X-Microsystems/xmicro-6502/README.md

# XMICRO-6502

W65C02 CPU card for the [XMICRO Bus](https://github.com/X-Microsystems/xmicro-bus).

Datasheet: [XMICRO-6502](Documentation/XMICRO-6502.pdf)

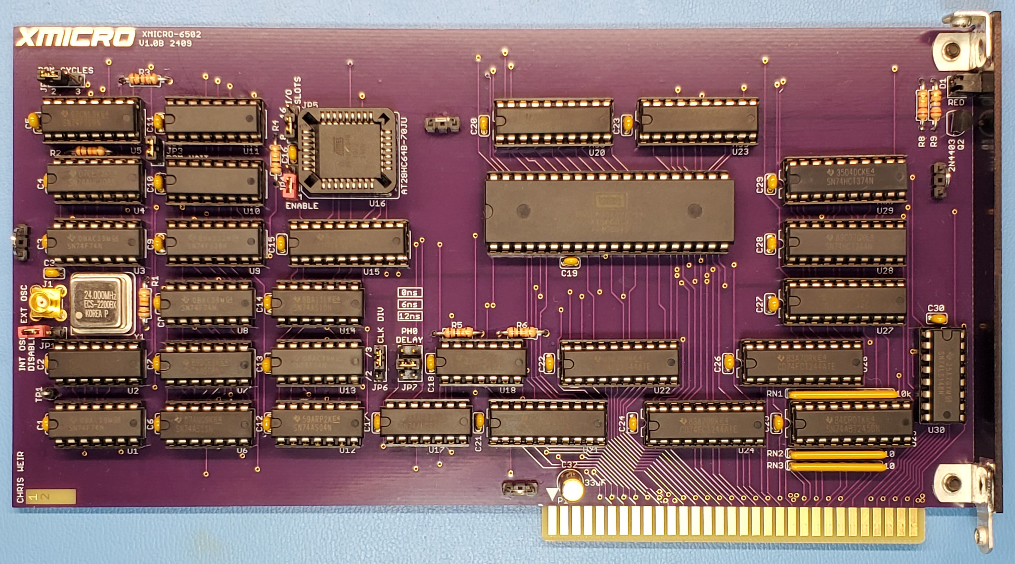
[picture p1: Images/XMICRO-6502 1.jpg]
XMICRO-6502
