X-Microsystems/xmicro-6502/Documentation/Schematics/XMICRO-6502 V2.3 Netlist.txt

Netlist

Exported from XMICRO-6502 V2.3.sch at 12/8/2019 8:15:32 PM

EAGLE Version 6.3.0 Copyright (c) 1988-2012 CadSoft

Net      Part     Pad      Pin        Sheet

!BBUSACK PC0      20       !BUSACK    6
         U8       7        Y2         1

!BCBR    PC0      12       !CBR       6
         U4       11       I          4

!BCSX    PC0      9        !CSX       6
         U1       4        G2A        5
         U2       5        G2B        5

!BFETCH  PC0      19       !FETCH     6
         U8       14       Y3         1

!BHALT   PC0      17       !HALT      6
         U8       5        Y3         1

!BINH    PC0      11       !INH       6
         U17      11       O          3

!BINT    PC0      51       !INT       6
         U18      10       I1         1

!BIOSEL  PC0      16       !IOSEL     6
         U25      18       Y1         1

!BIRQ0   PC0      53       !IRQ0      6
         U27      2        I1         3

!BIRQ1   PC0      54       !IRQ1      6
         U27      5        I1         3

!BIRQ2   PC0      55       !IRQ2      6
         U27      13       I1         3

!BIRQ3   PC0      56       !IRQ3      6
         U27      10       I1         3

!BIRQ4   PC0      57       !IRQ4      6
         U28      5        I1         3

!BIRQ5   PC0      58       !IRQ5      6
         U28      2        I1         3

!BIRQ6   PC0      59       !IRQ6      6
         U28      13       I1         3

!BIRQ7   PC0      60       !IRQ7      6
         U28      10       I1         3

!BIRQX   PC0      52       !IRQX      6
         U10      8        !Q         4

!BNMI    JP5      1        1          1
         PC0      61       !NMI       6

!BRD     PC0      21       !RD        6
         U1       5        G2B        5
         U2       2        B          5
         U8       18       Y1         1

!BRST    PC0      14       !RST       6
         U31      1        I          1

!BUSACK  U10      10       PRE        4
         U8       13       A2         1
         U9       10       PRE        4
         U9       6        !Q         4

!BWAIT   PC0      18       !WAIT      6
         U31      13       I          1

!BWR     PC0      22       !WR        6
         U2       3        C          5
         U8       16       Y2         1

!CINT    U18      8        O          1
         U20      4        !IRQB      1

!CS0_READ U12      1        G          2
         U12      19       G          2
         U2       11       Y4         5

!CS0_WRITE U10      3        CLK        2
         U11      11       CLK        2
         U2       13       Y2         5

!CS1_READ U2       10       Y5         5
         U21      1        G          3
         U21      19       G          3

!CS1_WRITE U2       12       Y3         5
         U26      11       CLK        3

!HALT    R2       1        1          6
         U17      8        O          1
         U8       15       A3         1

!IOSEL   U25      2        A1         1
         U6       19       P=Q        5

!IVP     U16      1        OC         3
         U18      4        I0         4
         U22      9        Y6         3

!MLB     U18      2        I1         4
         U20      5        !MLB       1

!RD      U17      3        O          1
         U22      5        G2B        3
         U8       2        A1         1

!RST     U10      4        PRE        2
         U11      1        CLR        2
         U18      5        I1         4
         U20      40       !RESB      1
         U26      1        CLR        3
         U31      4        O          1
         U9       1        CLR        4
         U9       13       CLR        4

!VINT    U18      9        I0         1
         U23      14       GS         3

!VPB     JP3      2        2          2
         U19      5        I          3
         U20      1        !VPB       1
         U22      4        G2A        3

!WAIT_DMA R7       2        2          1
         U17      9        I0         1
         U9       8        !Q         4

!WR      U17      6        O          1
         U8       4        A2         1

A0       U20      9        A0         1
         U22      1        A          3
         U24      17       A4         1

A1       U18      12       I0         3
         U20      10       A1         1
         U22      2        B          3
         U24      2        A1         1

A2       U18      13       I1         3
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
         U23      5        EI         3
         U23      8        GND        * none *
         U24      10       GND        * none *
         U25      10       GND        * none *
         U26      10       GND        * none *
         U27      7        GND        * none *
         U28      7        GND        * none *
         U29      8        GND        * none *
         U3       7        GND        * none *
         U30      7        GND        * none *
         U31      7        GND        * none *
         U4       7        GND        * none *
         U5       10       3B         2
         U5       13       4B         2
         U5       3        1B         2
         U5       6        2B         2
         U5       8        GND        * none *
         U6       10       GND        * none *
         U6       18       Q7         5
         U7       10       GND        * none *
         U7       12       Q4         2
         U7       14       Q5         2
         U7       16       Q6         2
         U7       18       Q7         2
         U7       5        Q1         2
         U7       7        Q2         2
         U7       9        Q3         2
         U8       10       GND        * none *
         U8       11       A1         1
         U8       19       G          1
         U8       8        A4         1
         U9       12       D          4
         U9       7        GND        * none *
         Y1       4        GND        1

ID0      U13      2        A1         5

ID1      U13      17       A4         5

ID2      U13      4        A2         5

ID3      U13      15       A3         5

ID4      U13      6        A3         5

ID5      U13      13       A2         5

ID6      U13      8        A4         5

ID7      U13      11       A1         5

N$1      JP2      2        2          1
         U30      12       D          1

N$2      U17      5        I1         1
         U19      4        O          1

N$3      JP1      1        1          1
         JP2      3        3          1
         U3       1        I0         1
         U30      5        Q          1

N$4      U15      1        DIR        1
         U17      1        I0         1
         U19      3        I          1
         U20      34       R!WB       1

N$5      U3       5        I1         1
         U30      9        Q          1

N$6      U16      4        3D         3
         U23      9        A0         3

N$7      U16      5        4D         3
         U23      7        A1         3

N$8      U3       6        O          1
         U4       5        I          1

N$9      R5       1        1          1
         Y1       1        OE         1

N$10     JP4      2        2          5
         R4       1        1          5
         U6       1        G          5

N$11     U17      10       I1         1
         U19      12       O          1

N$12     U18      3        O          4
         U9       2        D          4

N$13     U19      11       I          3
         U23      15       EO         3

N$14     U17      13       I1         3
         U19      6        O          3

N$15     U14      1        G          3
         U14      19       G          3
         U22      7        Y7         3

N$16     U10      13       CLR        4
         U18      6        O          4

N$17     U18      1        I0         4
         U4       10       O          4

N$18     U16      6        5D         3
         U23      6        A2         3

N$19     U11      19       Q8         2
         U12      2        A1         2
         U5       2        1A         2

N$20     Q1       2        B          6
         R2       2        2          6

N$21     U3       2        I1         1
         U4       6        O          1

N$22     U17      12       I0         3
         U18      11       O          3

N$23     U4       12       O          4
         U4       3        I          4

N$24     Q1       3        C          6
         R1       2        2          6

N$25     U4       4        O          4
         U9       3        CLK        4

N$26     D1       A        A          6
         R1       1        1          6

N$27     U11      5        Q2         2
         U12      4        A2         2
         U5       11       3A         2

N$28     U15      11       B8         1
         U20      26       D7         1

N$29     U15      12       B7         1
         U20      27       D6         1

N$30     U15      13       B6         1
         U20      28       D5         1

N$31     U15      14       B5         1
         U20      29       D4         1

N$32     U15      15       B4         1
         U20      30       D3         1

N$33     U15      16       B3         1
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
         U21      20       VCC        * none *
         U22      16       VCC        * none *
         U22      6        G1         3
         U23      16       VCC        * none *
         U24      20       VCC        * none *
         U25      20       VCC        * none *
         U26      20       VCC        * none *
         U27      14       VCC        * none *
         U28      14       VCC        * none *
         U29      10       3B         2
         U29      11       3A         2
         U29      13       4B         2
         U29      14       4A         2
         U29      16       VCC        * none *
         U29      5        2A         2
         U29      6        2B         2
         U3       14       VCC        * none *
         U30      1        CLR        1
         U30      10       PRE        1
         U30      13       CLR        1
         U30      14       VCC        * none *
         U30      4        PRE        1
         U31      14       VCC        * none *
         U31      5        I          6
         U31      9        I          6
         U4       14       VCC        * none *
         U5       16       VCC        * none *
         U6       12       Q4         5
         U6       14       Q5         5
         U6       16       Q6         5
         U6       2        P0         5
         U6       20       VCC        * none *
         U6       3        Q0         5
         U6       4        P1         5
         U6       5        Q1         5
         U6       6        P2         5
         U6       7        Q2         5
         U6       8        P3         5
         U6       9        Q3         5
         U7       2        P0         2
         U7       20       VCC        * none *
         U7       3        Q0         2
         U8       20       VCC        * none *
         U9       14       VCC        * none *
         U9       4        PRE        4
         Y1       8        VCC        1
