X-Microsystems/xmicro-6502/Images/XMICRO-6502 2.jpg

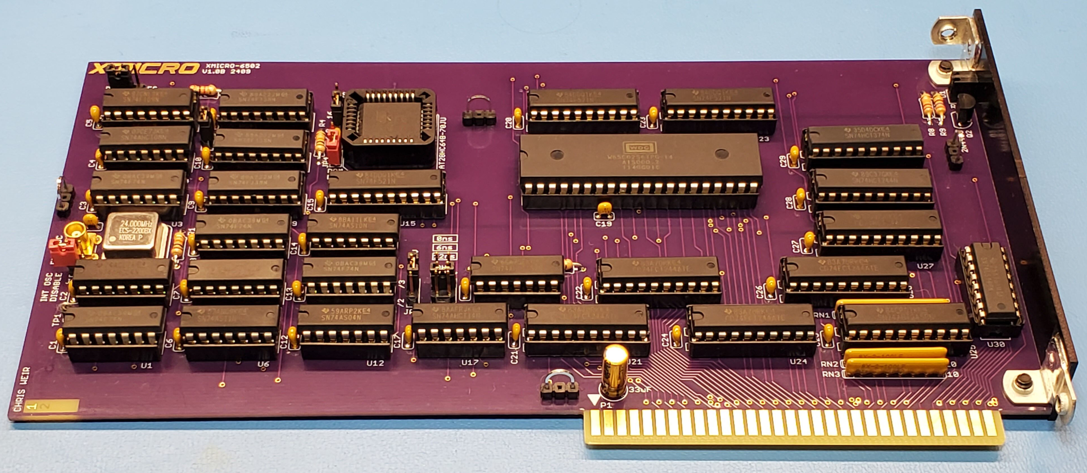
Images/XMICRO-6502 2.jpg
