X-Microsystems/xmicro-6502/Images/XMICRO-6502 Gen 1.jpg

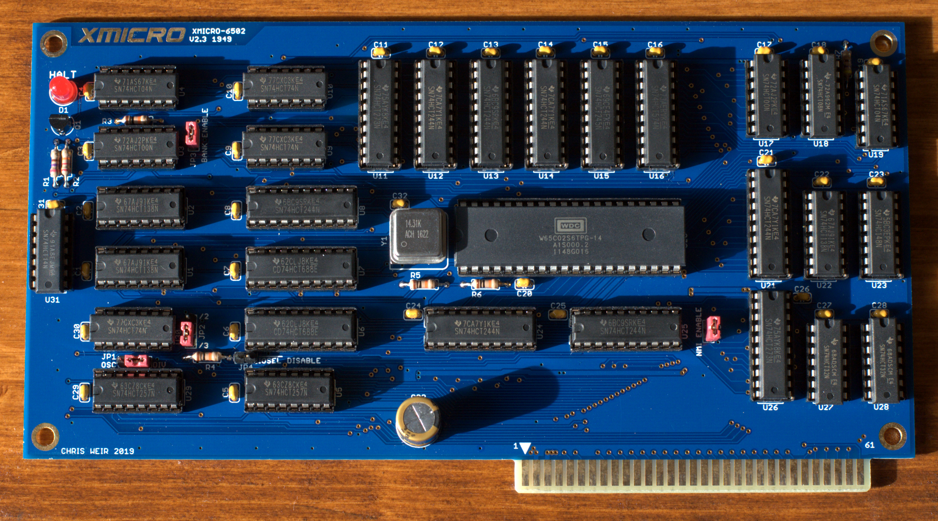
Images/XMICRO-6502 Gen 1.jpg
