X-Microsystems/xmicro-6502/Documentation/Schematics/XMICRO-6502 V1.0B Black.pdf

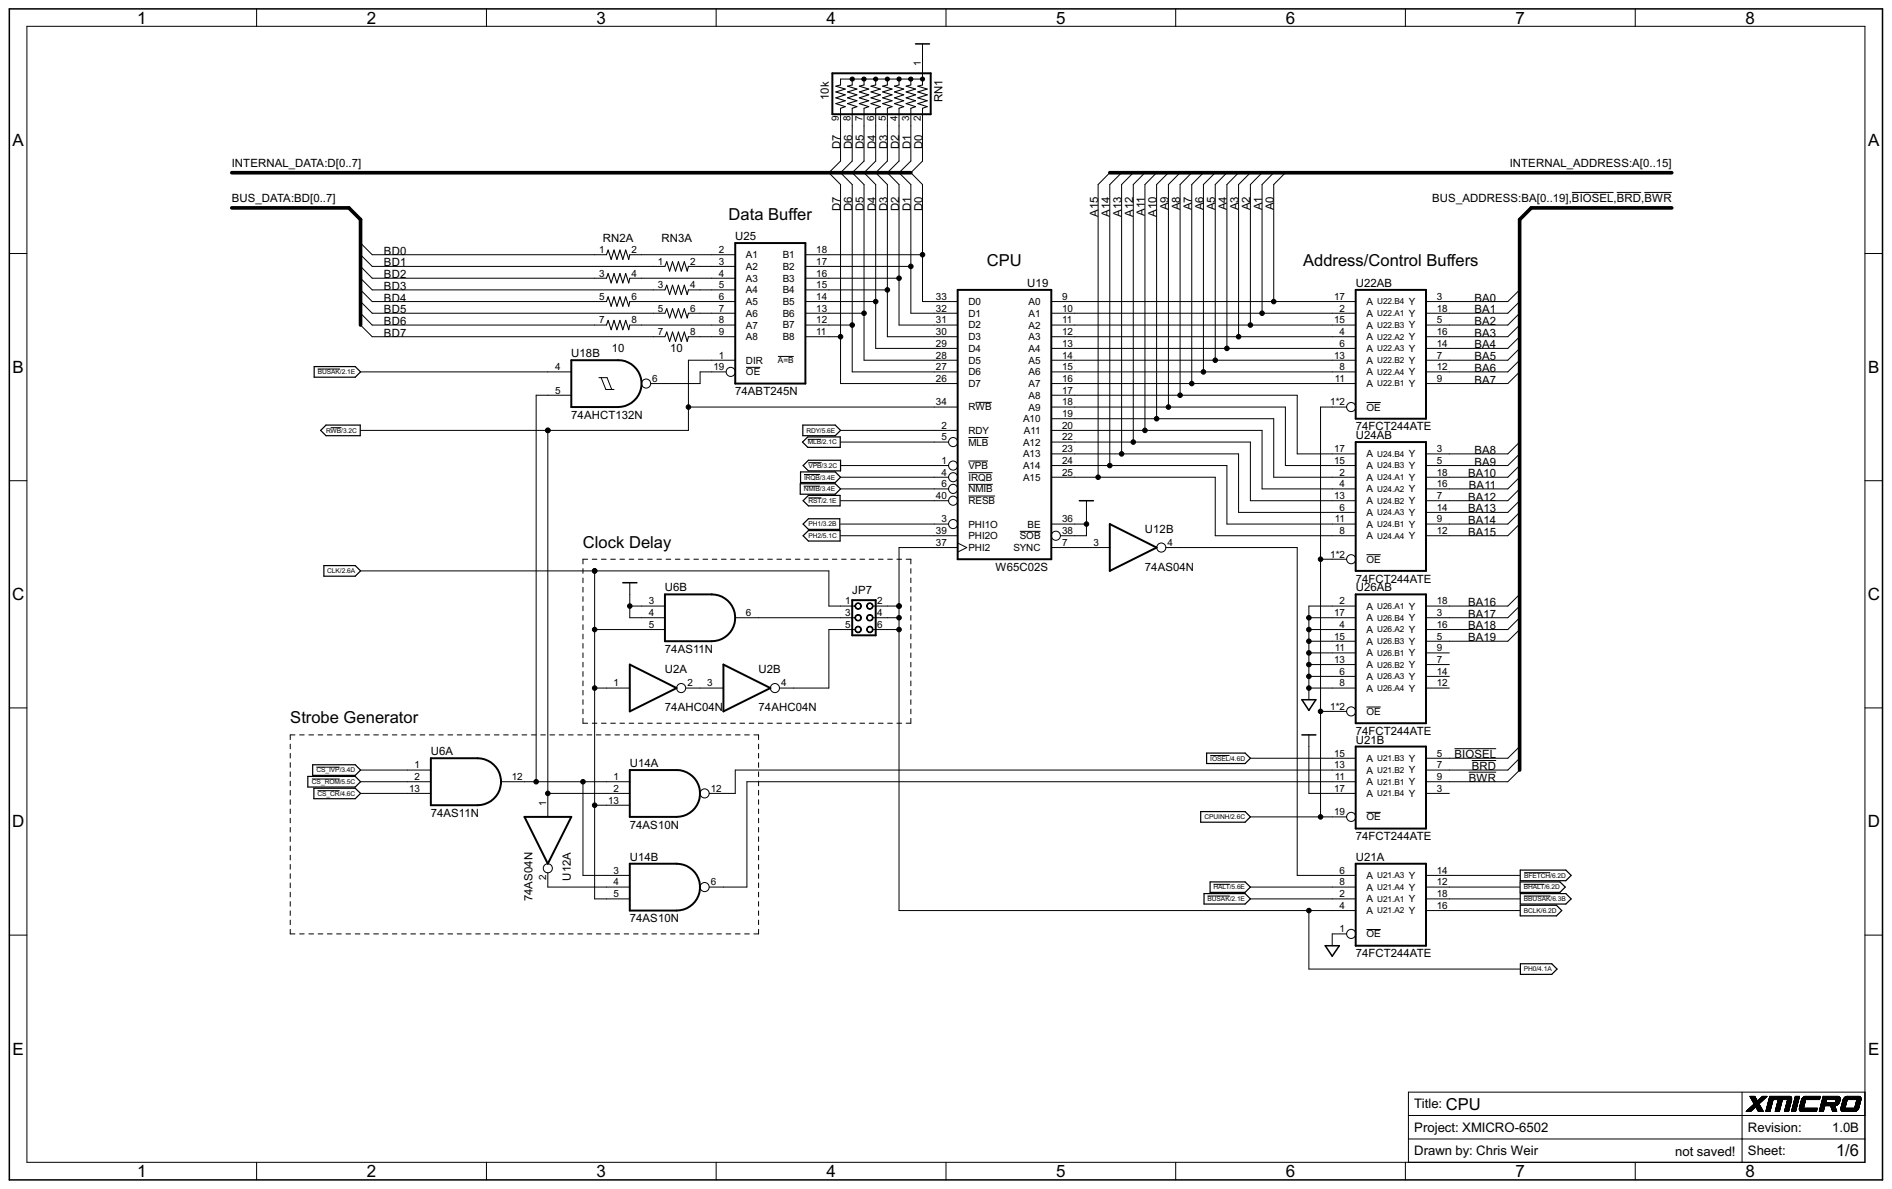
[picture p10: page 1]

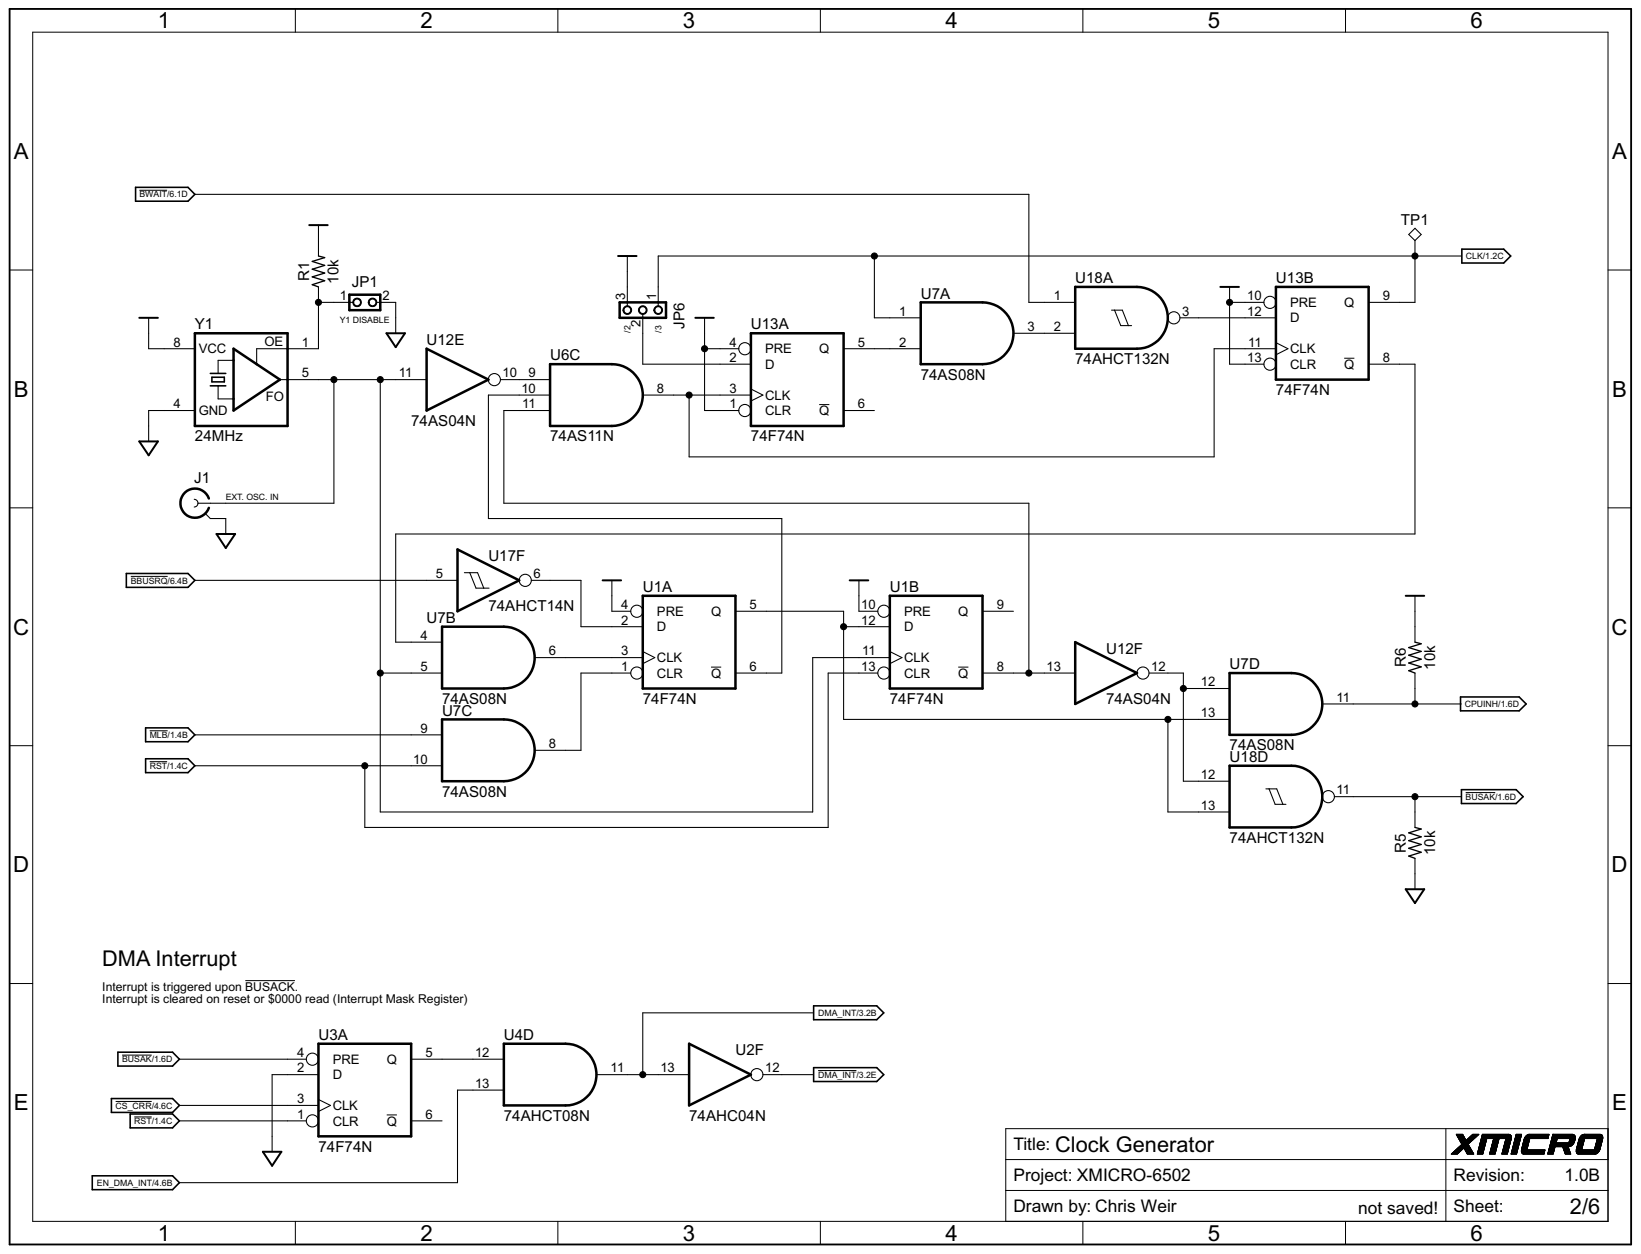
[picture p11: page 2]

Interrupt is triggered upon BUSACK.
Interrupt is cleared on reset or $0000 read (Interrupt Mask Register)

Title: Project: Drawn by: Clock Generator XMICRO-6502 | Revision: Chris Weir Sheet: 2/6 1.0B

not saved!

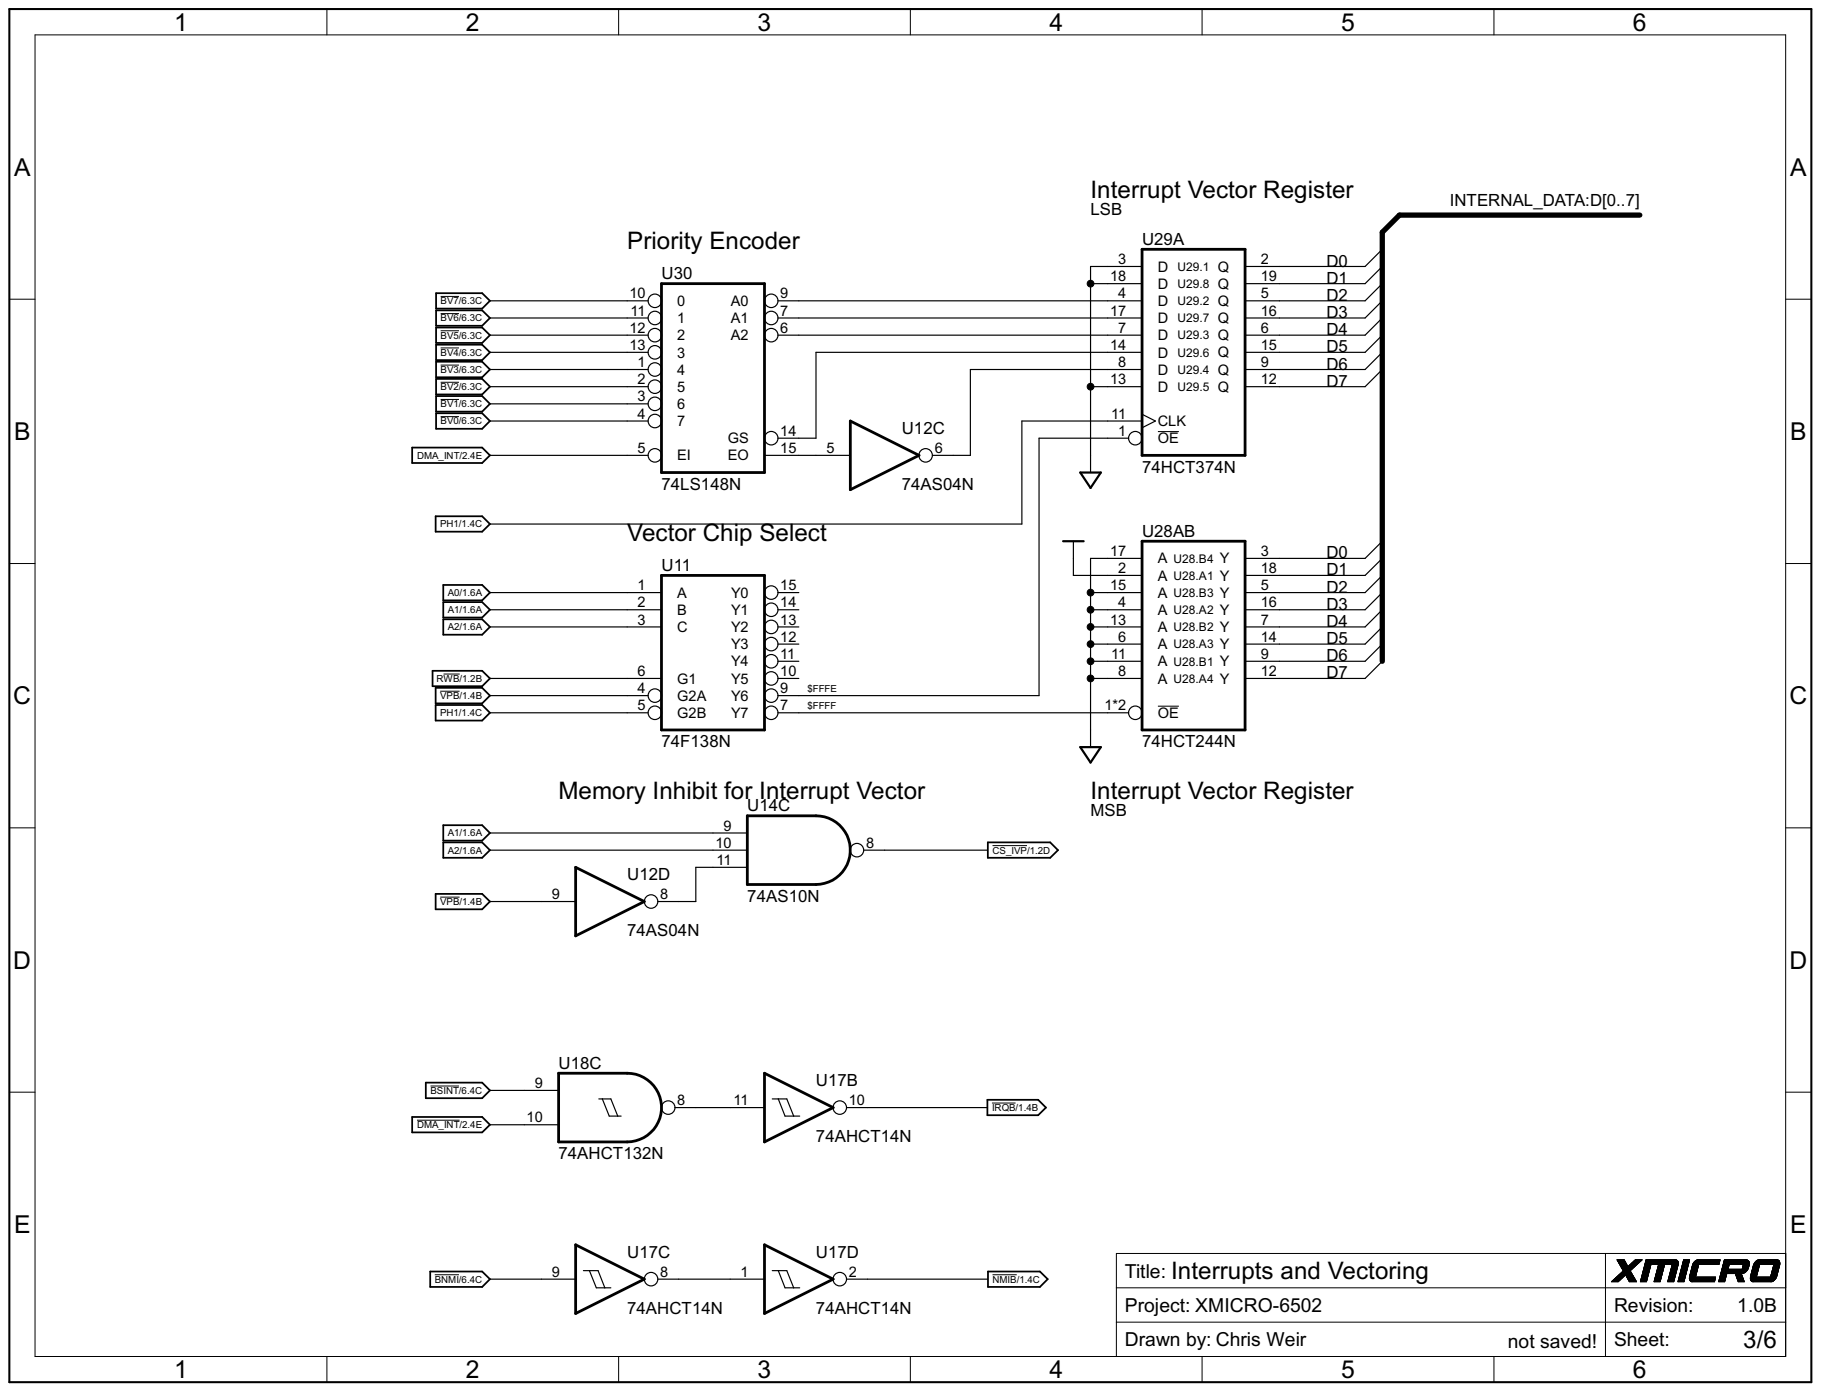
[picture p12: page 3]

Memory Inhibit for Interrupt Vector

Interrupts and Vectoring
Title: Project: XMICRO-6502 | Revision: Chris Weir Sheet: 3/6 1.0B

Drawn by:

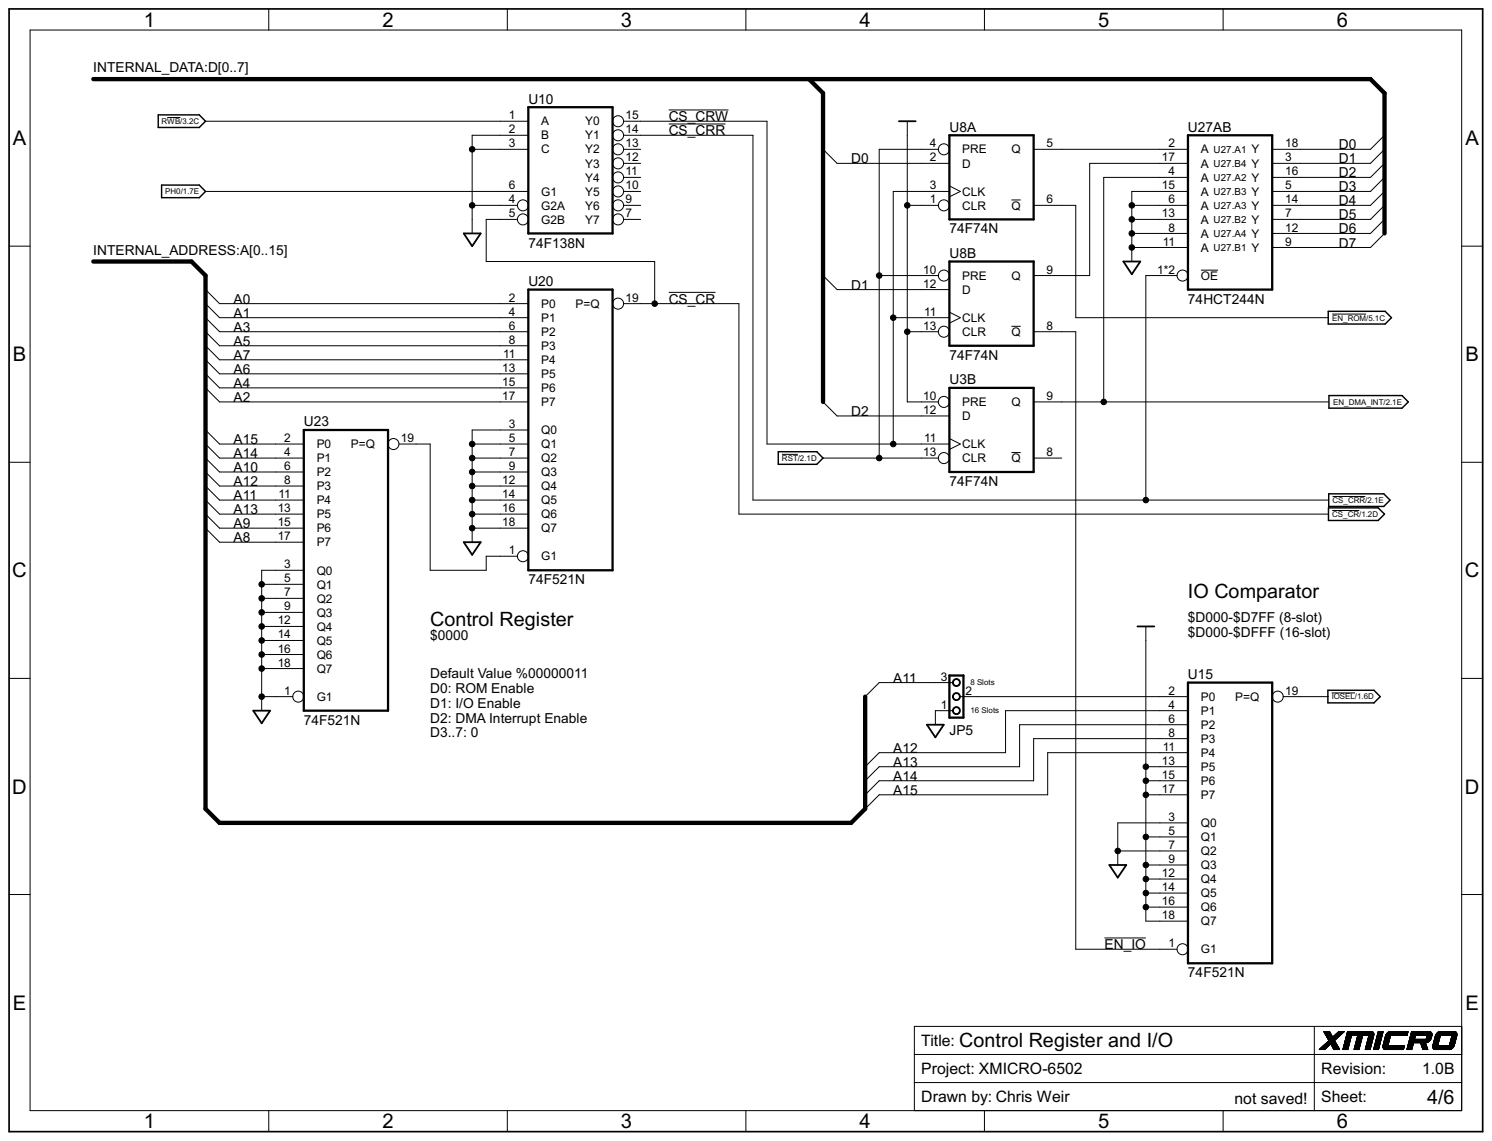
[picture p13: page 4]

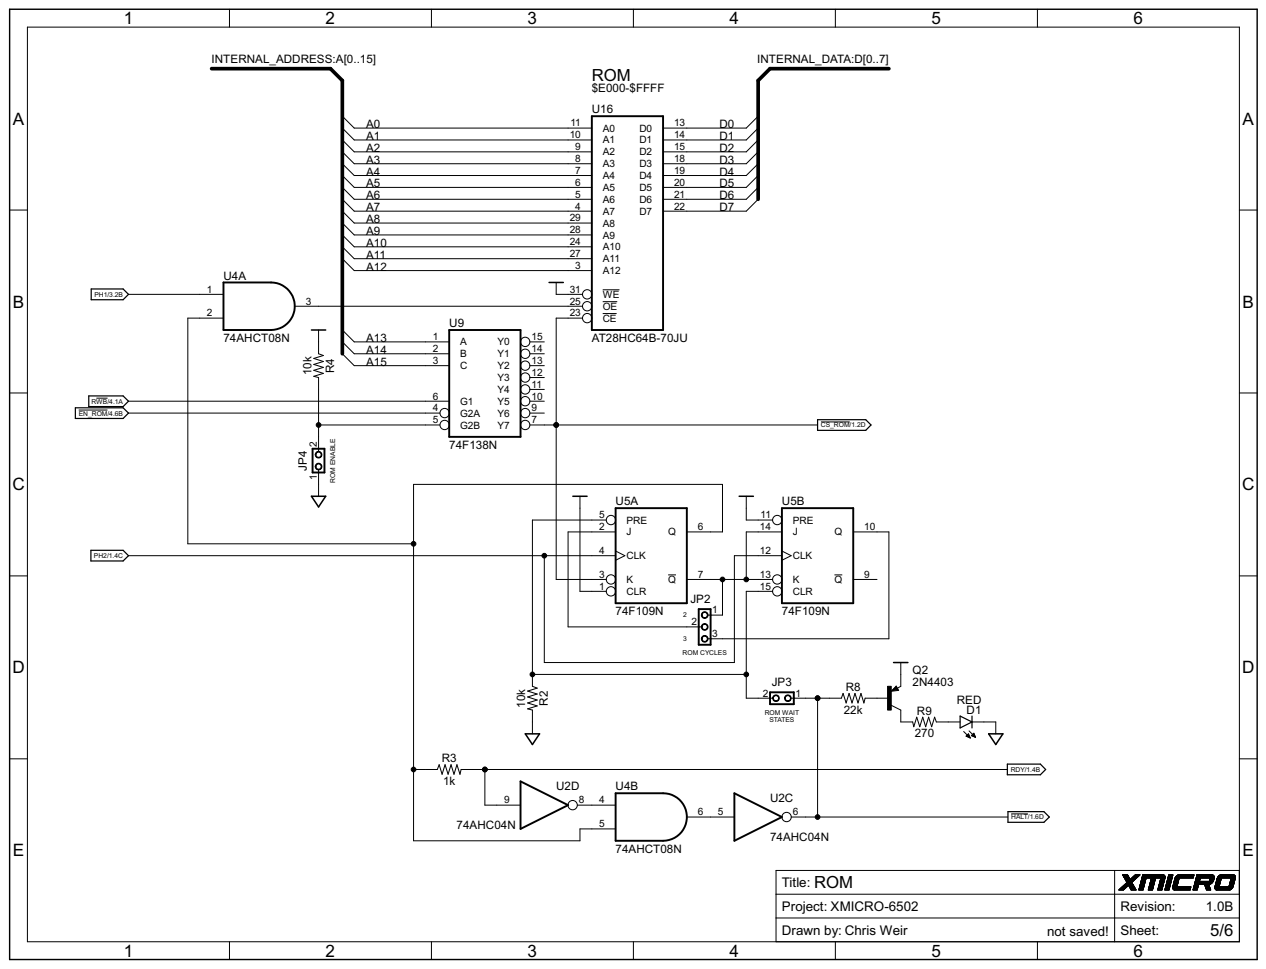
[picture p14: page 5]

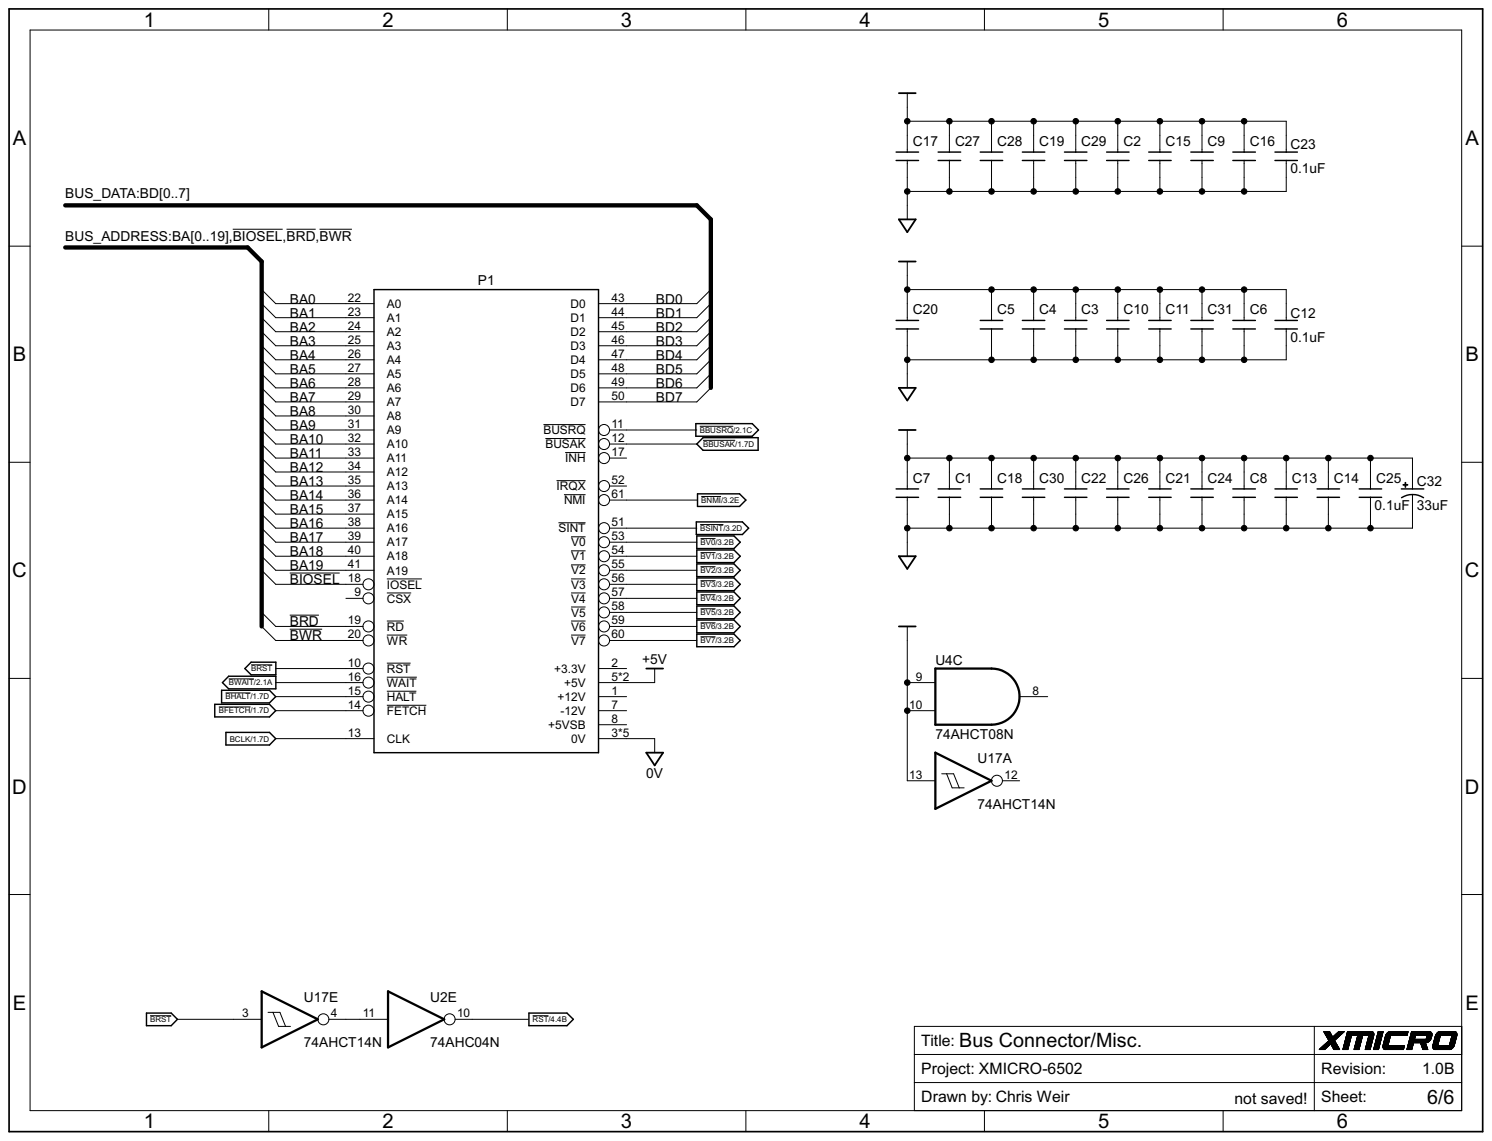
[picture p15: page 6]

BUS_ADDRESS:BA[0..19],BIOSEL,BRD,BWR

Drawn by: Bus Connector/Misc.
