X-Microsystems/xmicro-6502/Documentation/Document Resources/6.pdf

BUS_ADDRESS:BA[0..19],BIOSEL,BRD,BWR

Title: Project: Drawn by: Bus Connector/Misc. XMICRO-6502 | Revision: Chris Weir Sheet: 6/6 1.0B

not saved!
