X-Microsystems/xmicro-6502/Documentation/Schematics/XMICRO-6502 V1.0B Black Large.pdf

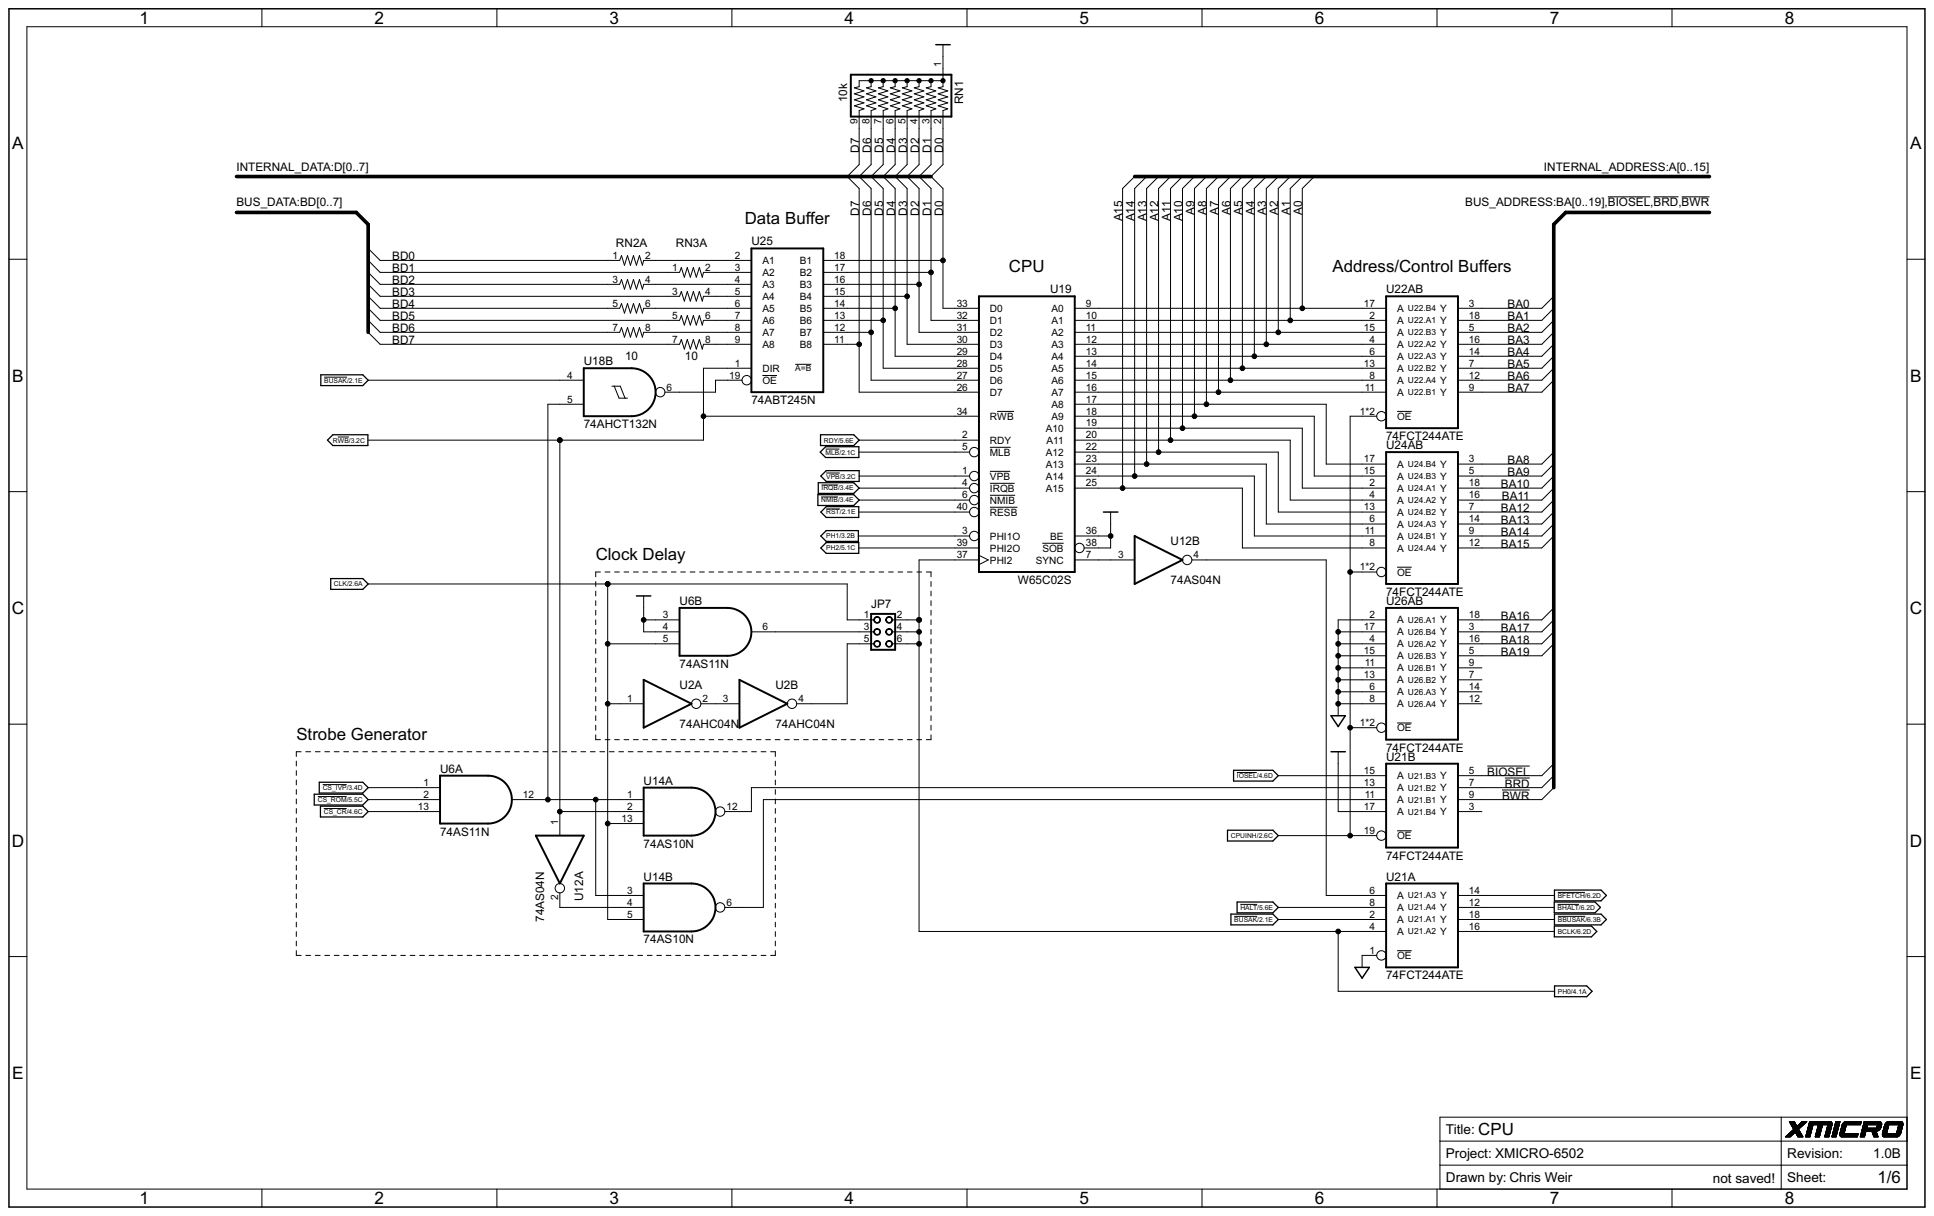
[picture p22: page 1]

Title: Project: Drawn by: CPU XMICRO-6502 | Revision: Chris Weir Sheet: 1/6 1.0B

not saved!
