X-Microsystems/xmicro-6502/Hardware/CAD/XMICRO-6502 V2.4.brd

## EAGLE design Hardware/CAD/XMICRO-6502 V2.4.brd (2020-03-30)

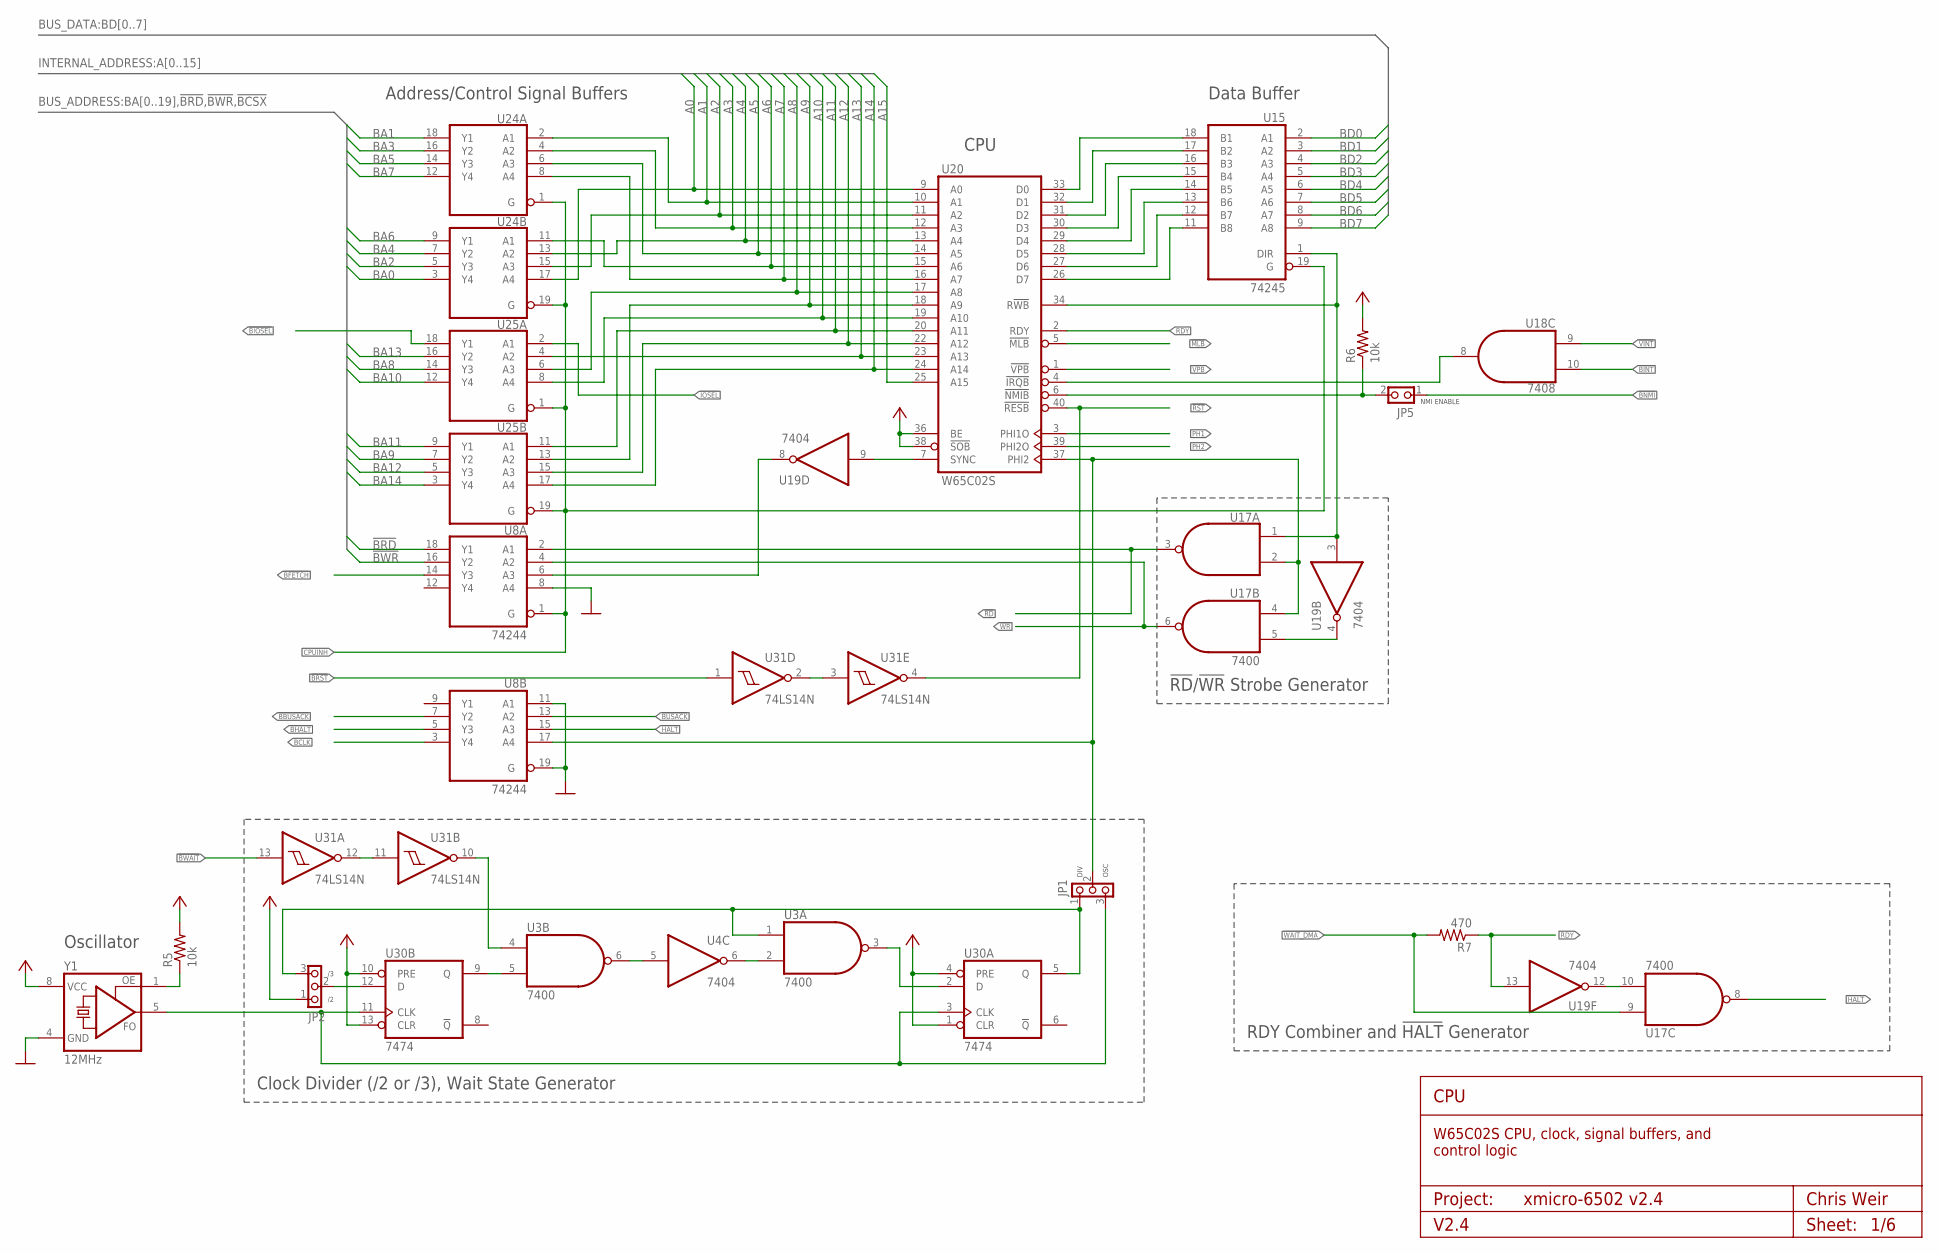
[picture p23: schematic XMICRO-6502 V2.4.sch, sheet 1, CPU]

Parts:
JP1, JP2: PINHD1X3THRU; 1X03
JP5: PINHD-1X2THRU; 1X02
R5, R6: 10k; 0207/10
R7: 470; 0207/10
U3, U17: 7400; DIL14
U4, U19: 7404; DIL14
U8, U24, U25: 74244; DIL20
U15: 74245; DIL20
U18: 7408; DIL14
U20: W65C02S; DIL40
U30: 7474; DIL14
U31: 74LS14N; DIL14
Y1: 12MHz; DIL08S

Connections:
!BBUSACK: U8.7 (Y2); also elsewhere on the board
!BFETCH: U8.14 (Y3); also elsewhere on the board
!BHALT: U8.5 (Y3); also elsewhere on the board
!BINT: U18.10 (I1); also elsewhere on the board
!BIOSEL: U25.18 (Y1); also elsewhere on the board
!BNMI: JP5.1; also elsewhere on the board
!BRD: U8.18 (Y1); also elsewhere on the board
!BRST: U31.1 (I); also elsewhere on the board
!BUSACK: U8.13 (A2); also elsewhere on the board
!BWAIT: U31.13 (I); also elsewhere on the board
!BWR: U8.16 (Y2); also elsewhere on the board
!CINT: U18.8 (O), U20.4 (!IRQB)
!HALT: U8.15 (A3), U17.8 (O); also elsewhere on the board
!IOSEL: U25.2 (A1); also elsewhere on the board
!MLB: U20.5 (!MLB); also elsewhere on the board
!RD: U8.2 (A1), U17.3 (O); also elsewhere on the board
!RST: U20.40 (!RESB), U31.4 (O); also elsewhere on the board
!VINT: U18.9 (I0); also elsewhere on the board
!VPB: U20.1 (!VPB); also elsewhere on the board
!WAIT_DMA: R7.2, U17.9 (I0); also elsewhere on the board
!WR: U8.4 (A2), U17.6 (O)
A0: U20.9 (A0), U24.17 (A4); also elsewhere on the board
A1: U20.10 (A1), U24.2 (A1); also elsewhere on the board
A2: U20.11 (A2), U24.15 (A3); also elsewhere on the board
A3: U20.12 (A3), U24.4 (A2)
A4: U20.13 (A4), U24.13 (A2)
A5: U20.14 (A5), U24.6 (A3)
A6: U20.15 (A6), U24.11 (A1)
A7: U20.16 (A7), U24.8 (A4)
A8: U20.17 (A8), U25.6 (A3)
A9: U20.18 (A9), U25.13 (A2); also elsewhere on the board
A10: U20.19 (A10), U25.8 (A4); also elsewhere on the board
A11: U20.20 (A11), U25.11 (A1); also elsewhere on the board
A12: U20.22 (A12), U25.15 (A3); also elsewhere on the board
A13: U20.23 (A13), U25.4 (A2); also elsewhere on the board
A14: U20.24 (A14), U25.17 (A4); also elsewhere on the board
A15: U20.25 (A15); also elsewhere on the board
BA0: U24.3 (Y4); also elsewhere on the board
BA1: U24.18 (Y1); also elsewhere on the board
BA2: U24.5 (Y3); also elsewhere on the board
BA3: U24.16 (Y2); also elsewhere on the board
BA4: U24.7 (Y2); also elsewhere on the board
BA5: U24.14 (Y3); also elsewhere on the board
BA6: U24.9 (Y1); also elsewhere on the board
BA7: U24.12 (Y4); also elsewhere on the board
BA8: U25.14 (Y3); also elsewhere on the board
BA9: U25.7 (Y2); also elsewhere on the board
BA10: U25.12 (Y4); also elsewhere on the board
BA11: U25.9 (Y1); also elsewhere on the board
BA12: U25.5 (Y3); also elsewhere on the board
BA13: U25.16 (Y2); also elsewhere on the board
BA14: U25.3 (Y4); also elsewhere on the board
BCLK: U8.3 (Y4); also elsewhere on the board
BD0: U15.2 (A1); also elsewhere on the board
BD1: U15.3 (A2); also elsewhere on the board
BD2: U15.4 (A3); also elsewhere on the board
BD3: U15.5 (A4); also elsewhere on the board
BD4: U15.6 (A5); also elsewhere on the board
BD5: U15.7 (A6); also elsewhere on the board
BD6: U15.8 (A7); also elsewhere on the board
BD7: U15.9 (A8); also elsewhere on the board
CPUINH: U8.1 (G), U15.19 (G), U24.1 (G), U24.19 (G), U25.1 (G), U25.19 (G); also elsewhere on the board
GND: U3.7 (GND), U4.7 (GND), U8.8 (A4), U8.10 (GND), U8.11 (A1), U8.19 (G), U15.10 (GND), U17.7 (GND), U18.7 (GND), U19.7 (GND), U20.21 (GND), U24.10 (GND), U25.10 (GND), U30.7 (GND), U31.7 (GND), Y1.4 (GND); also elsewhere on the board
unnamed: JP2.2, U30.12 (D)
unnamed: U17.5 (I1), U19.4 (O)
unnamed: JP1.1, JP2.3, U3.1 (I0), U30.5 (Q)
unnamed: U15.1 (DIR), U17.1 (I0), U19.3 (I), U20.34 (R!WB)
unnamed: U3.5 (I1), U30.9 (Q)
unnamed: U3.6 (O), U4.5 (I)
unnamed: R5.1, Y1.1 (OE)
unnamed: U17.10 (I1), U19.12 (O)
unnamed: U3.2 (I1), U4.6 (O)
unnamed: U15.11 (B8), U20.26 (D7)
unnamed: U15.12 (B7), U20.27 (D6)
unnamed: U15.13 (B6), U20.28 (D5)
unnamed: U15.14 (B5), U20.29 (D4)
unnamed: U15.15 (B4), U20.30 (D3)
unnamed: U15.16 (B3), U20.31 (D2)
unnamed: U15.17 (B2), U20.32 (D1)
unnamed: U15.18 (B1), U20.33 (D0)
unnamed: U31.11 (I), U31.12 (O)
unnamed: JP5.2, R6.1, U20.6 (!NMIB)
unnamed: U3.3 (O), U30.2 (D)
unnamed: JP1.3, U30.3 (CLK), U30.11 (CLK), Y1.5 (FO)
unnamed: U19.9 (I), U20.7 (SYNC)
unnamed: U8.6 (A3), U19.8 (O)
unnamed: U3.4 (I0), U31.10 (O)
unnamed: U31.2 (O), U31.3 (I)
PH0: JP1.2, U8.17 (A4), U17.2 (I1), U17.4 (I0), U20.37 (PHI2)
PH1: U20.3 (PHI1O); also elsewhere on the board
PH2: U20.39 (PHI2O); also elsewhere on the board
RDY: R7.1, U19.13 (I), U20.2 (RDY)
VCC: JP2.1, R5.2, R6.2, U3.14 (VCC), U4.14 (VCC), U8.20 (VCC), U15.20 (VCC), U17.14 (VCC), U18.14 (VCC), U19.14 (VCC), U20.8 (VCC), U20.36 (BE), U20.38 (!SOB), U24.20 (VCC), U25.20 (VCC), U30.1 (CLR), U30.4 (PRE), U30.10 (PRE), U30.13 (CLR), U30.14 (VCC), U31.14 (VCC), Y1.8 (VCC); also elsewhere on the board

Notes on the sheet:
Project:
CPU
V2.4
Chris Weir
Sheet:
W65C02S CPU, clock, signal buffers, and control logic
Address/Control Signal Buffers
Data Buffer
!RD!/!WR! Strobe Generator
Oscillator
RDY Combiner and !HALT! Generator
Clock Divider (/2 or /3), Wait State Generator
DIV
OSC
NMI ENABLE

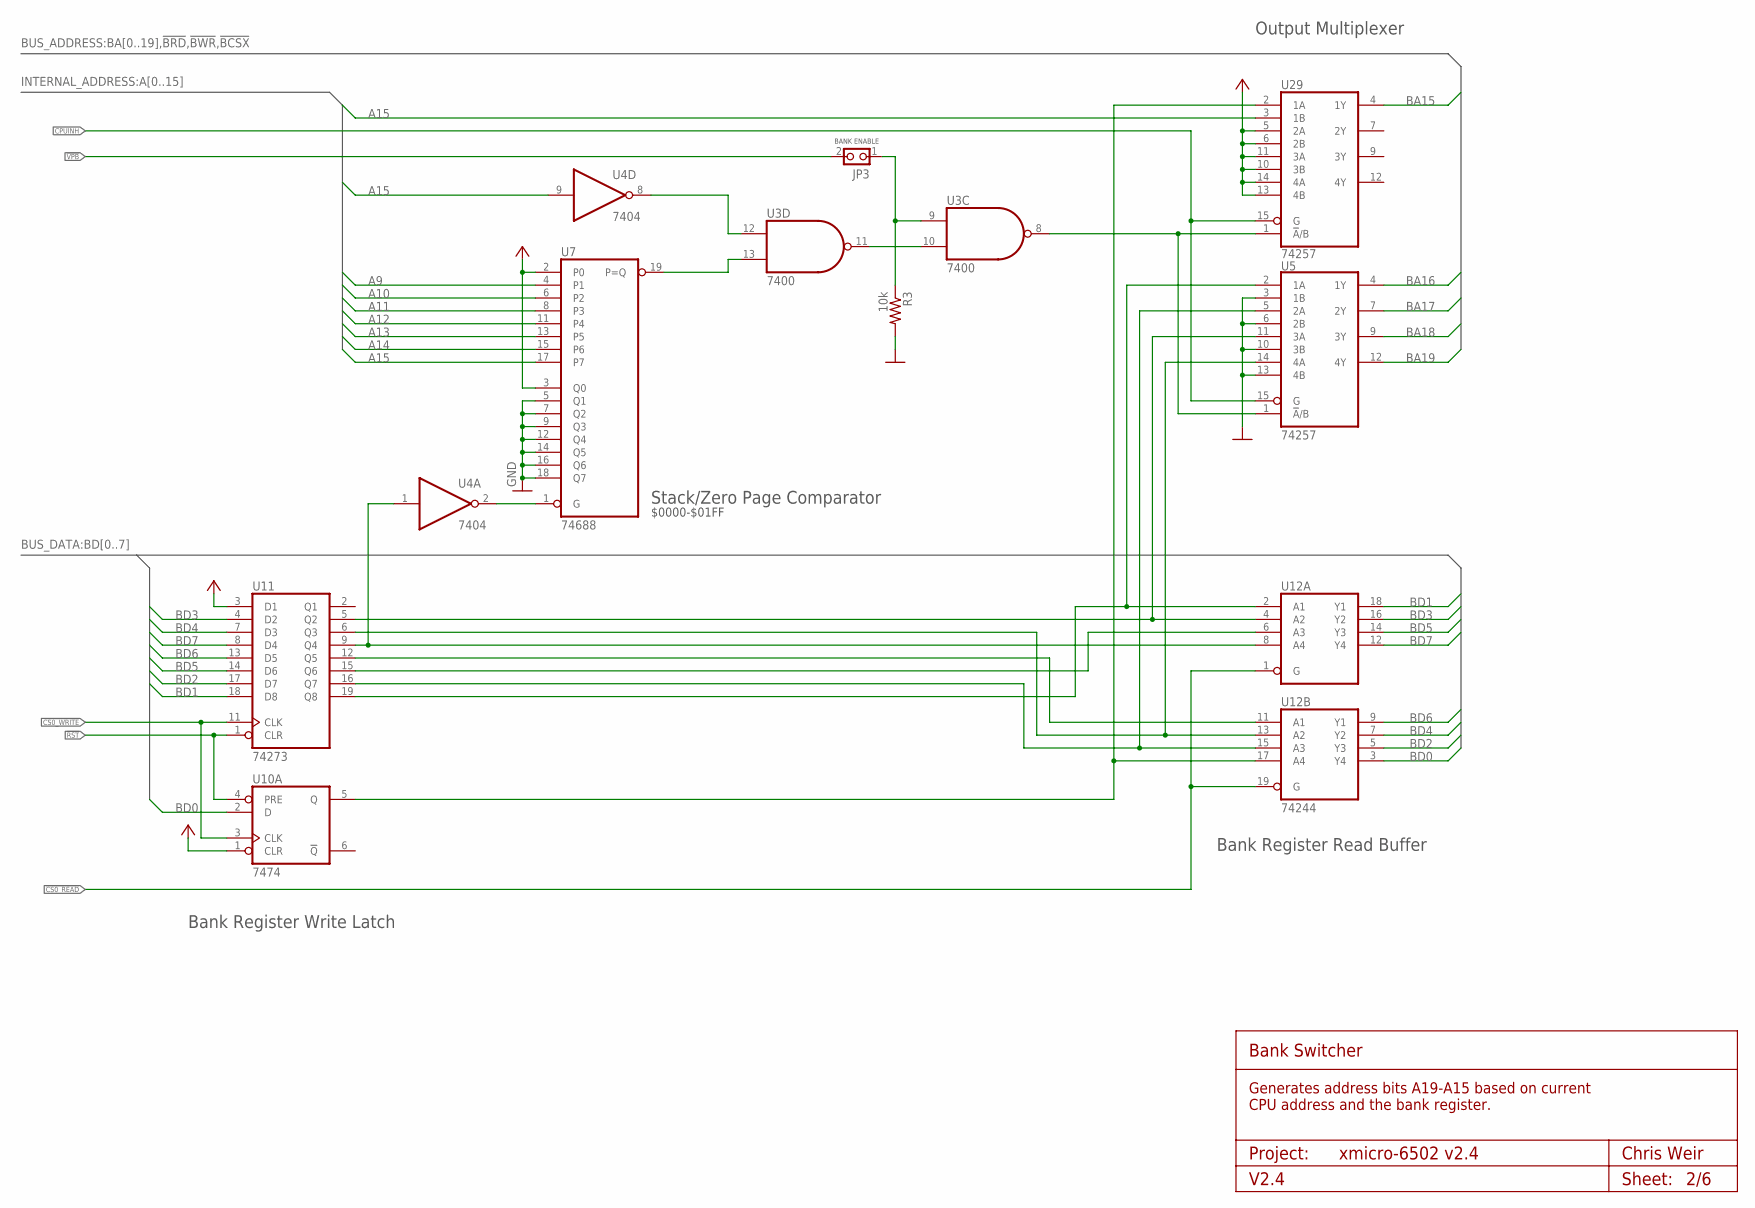
[picture p24: schematic XMICRO-6502 V2.4.sch, sheet 2, Bank Switcher]

Parts:
JP3: PINHD-1X2THRU; 1X02
R3: 10k; 0207/10
U3: 7400; DIL14
U4: 7404; DIL14
U5, U29: 74257; DIL16
U7: 74688; DIL20
U10: 7474; DIL14
U11: 74273; DIL20
U12: 74244; DIL20

Connections:
!CS0_READ: U12.1 (G), U12.19 (G); also elsewhere on the board
!CS0_WRITE: U10.3 (CLK), U11.11 (CLK); also elsewhere on the board
!RST: U10.4 (PRE), U11.1 (CLR); also elsewhere on the board
!VPB: JP3.2; also elsewhere on the board
A9: U7.4 (P1); also elsewhere on the board
A10: U7.6 (P2); also elsewhere on the board
A11: U7.8 (P3); also elsewhere on the board
A12: U7.11 (P4); also elsewhere on the board
A13: U7.13 (P5); also elsewhere on the board
A14: U7.15 (P6); also elsewhere on the board
A15: U4.9 (I), U7.17 (P7), U29.3 (1B); also elsewhere on the board
BA15: U29.4 (1Y); also elsewhere on the board
BA16: U5.4 (1Y); also elsewhere on the board
BA17: U5.7 (2Y); also elsewhere on the board
BA18: U5.9 (3Y); also elsewhere on the board
BA19: U5.12 (4Y); also elsewhere on the board
BD0: U10.2 (D), U12.3 (Y4); also elsewhere on the board
BD1: U11.18 (D8), U12.18 (Y1); also elsewhere on the board
BD2: U11.17 (D7), U12.5 (Y3); also elsewhere on the board
BD3: U11.4 (D2), U12.16 (Y2); also elsewhere on the board
BD4: U11.7 (D3), U12.7 (Y2); also elsewhere on the board
BD5: U11.14 (D6), U12.14 (Y3); also elsewhere on the board
BD6: U11.13 (D5), U12.9 (Y1); also elsewhere on the board
BD7: U11.8 (D4), U12.12 (Y4); also elsewhere on the board
CPUINH: U5.15 (G), U29.15 (G); also elsewhere on the board
GND: R3.2, U3.7 (GND), U4.7 (GND), U5.3 (1B), U5.6 (2B), U5.8 (GND), U5.10 (3B), U5.13 (4B), U7.5 (Q1), U7.7 (Q2), U7.9 (Q3), U7.10 (GND), U7.12 (Q4), U7.14 (Q5), U7.16 (Q6), U7.18 (Q7), U10.7 (GND), U11.10 (GND), U12.10 (GND), U29.8 (GND); also elsewhere on the board
unnamed: U5.2 (1A), U11.19 (Q8), U12.2 (A1)
unnamed: U5.11 (3A), U11.5 (Q2), U12.4 (A2)
unnamed: U5.5 (2A), U11.16 (Q7), U12.15 (A3)
unnamed: U5.14 (4A), U11.6 (Q3), U12.13 (A2)
unnamed: U3.12 (I0), U4.8 (O)
unnamed: U3.13 (I1), U7.19 (P=Q)
unnamed: U10.5 (Q), U12.17 (A4), U29.2 (1A)
unnamed: U3.10 (I1), U3.11 (O)
unnamed: JP3.1, R3.1, U3.9 (I0)
unnamed: U11.15 (Q6), U12.6 (A3)
unnamed: U3.8 (O), U5.1 (!A!/B), U29.1 (!A!/B)
unnamed: U11.12 (Q5), U12.11 (A1)
unnamed: U4.1 (I), U11.9 (Q4), U12.8 (A4)
unnamed: U4.2 (O), U7.1 (G)
VCC: U3.14 (VCC), U4.14 (VCC), U5.16 (VCC), U7.2 (P0), U7.3 (Q0), U7.20 (VCC), U10.1 (CLR), U10.14 (VCC), U11.3 (D1), U11.20 (VCC), U12.20 (VCC), U29.5 (2A), U29.6 (2B), U29.10 (3B), U29.11 (3A), U29.13 (4B), U29.14 (4A), U29.16 (VCC); also elsewhere on the board

Notes on the sheet:
$0000-$01FF
Bank Register Read Buffer
Bank Register Write Latch
Stack/Zero Page Comparator
Bank Switcher
Generates address bits A19-A15 based on current CPU address and the bank register.
Output Multiplexer
Project:
V2.4
Chris Weir
Sheet:
BANK ENABLE

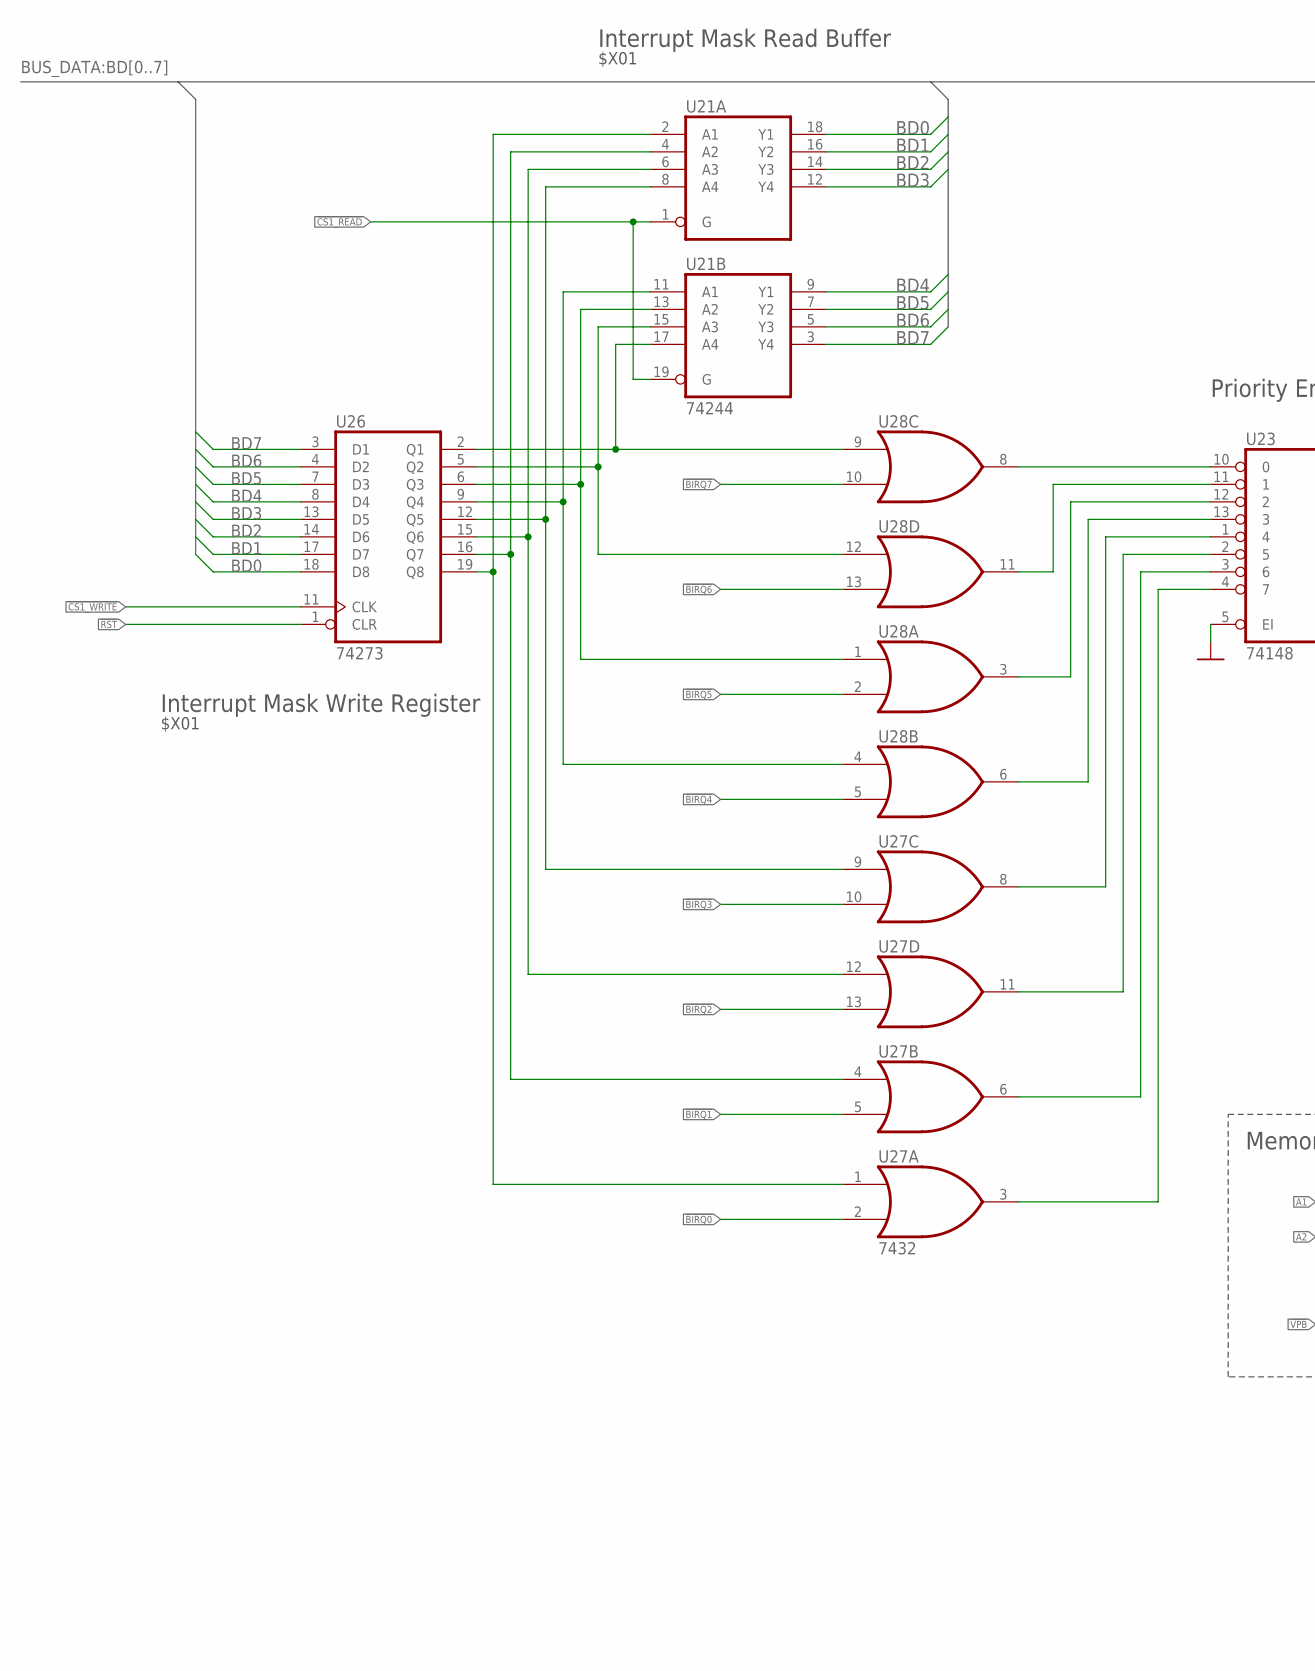
[picture p25: schematic XMICRO-6502 V2.4.sch, sheet 3, Interrupt Vector Generator, part in row 1, column 1]

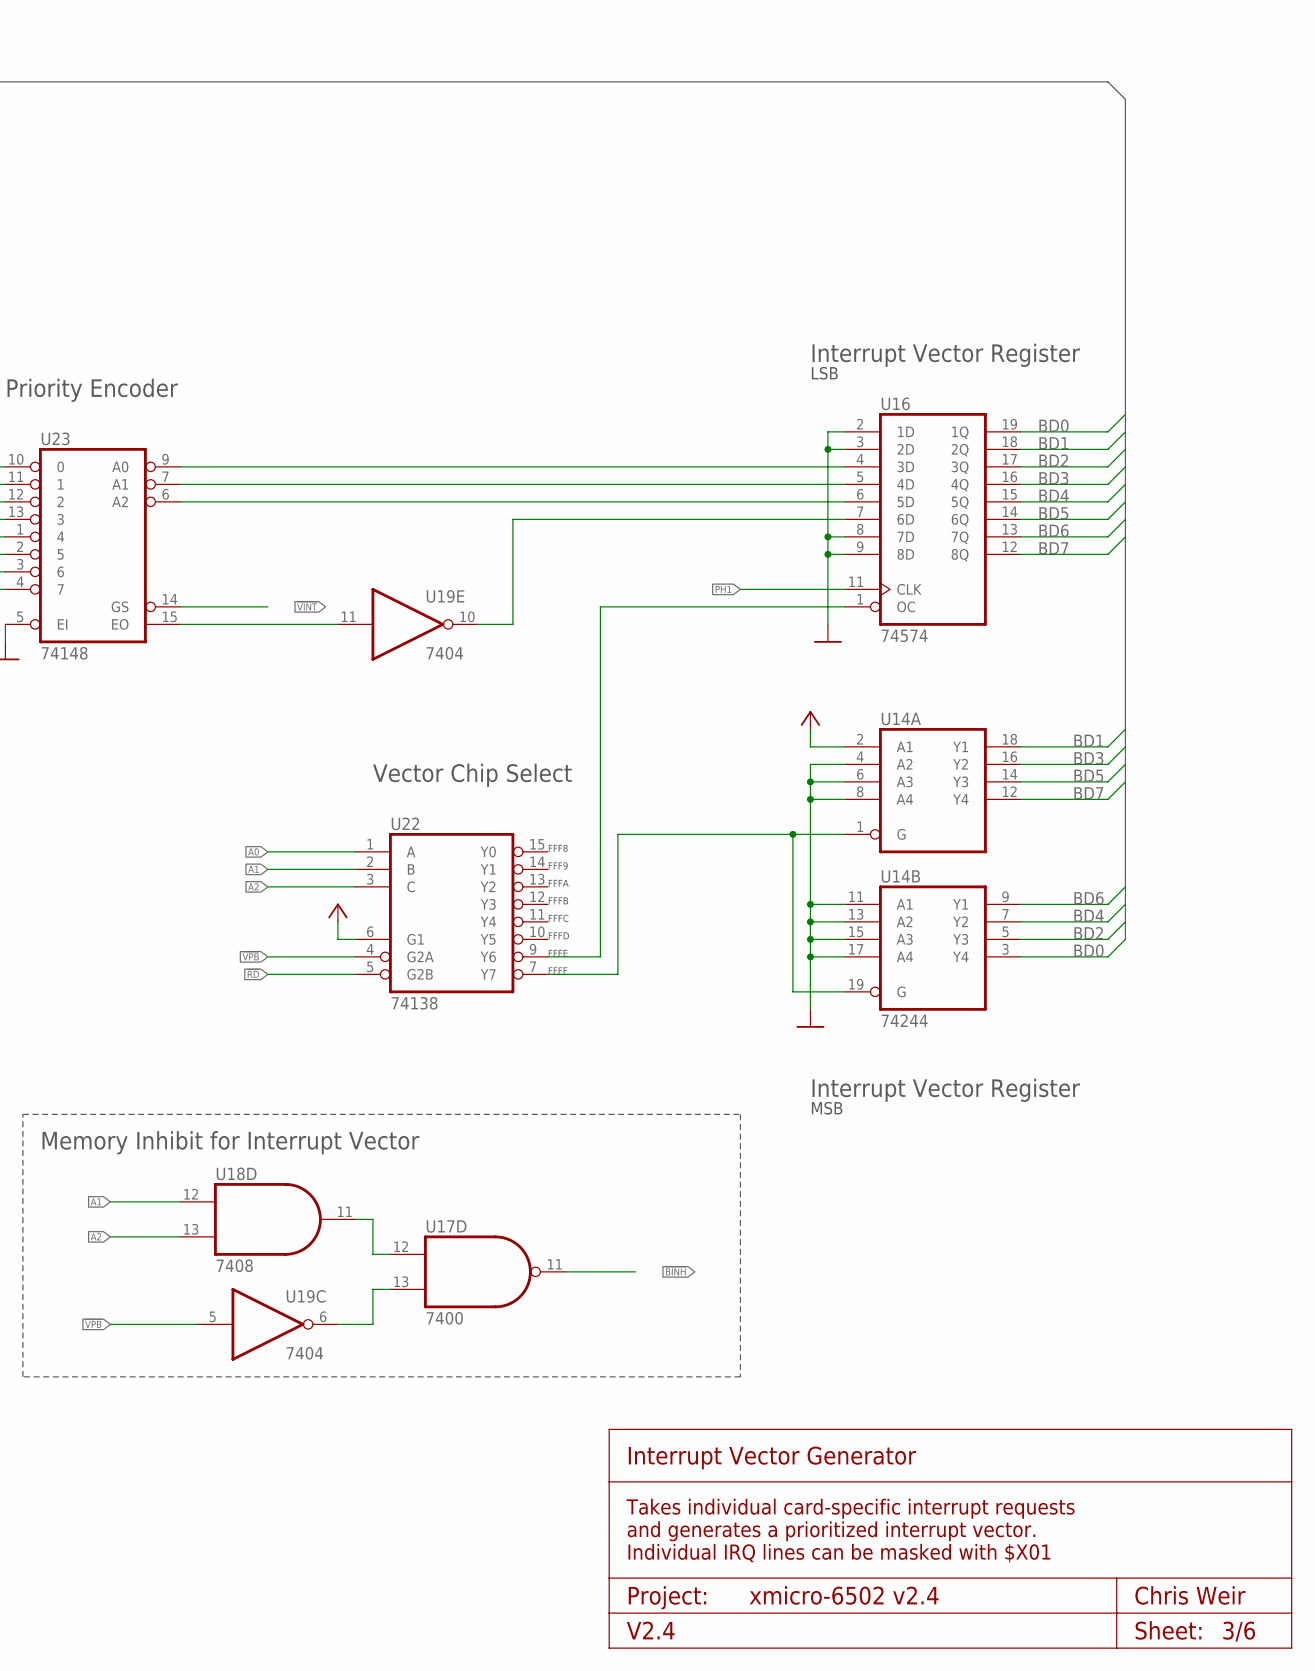
[picture p26: schematic XMICRO-6502 V2.4.sch, sheet 3, Interrupt Vector Generator, part in row 1, column 2]

Parts:
U14, U21: 74244; DIL20
U16: 74574; DIL20
U17: 7400; DIL14
U18: 7408; DIL14
U19: 7404; DIL14
U22: 74138; DIL16
U23: 74148; DIL16
U26: 74273; DIL20
U27, U28: 7432; DIL14

Connections:
!BINH: U17.11 (O); also elsewhere on the board
!BIRQ0: U27.2 (I1); also elsewhere on the board
!BIRQ1: U27.5 (I1); also elsewhere on the board
!BIRQ2: U27.13 (I1); also elsewhere on the board
!BIRQ3: U27.10 (I1); also elsewhere on the board
!BIRQ4: U28.5 (I1); also elsewhere on the board
!BIRQ5: U28.2 (I1); also elsewhere on the board
!BIRQ6: U28.13 (I1); also elsewhere on the board
!BIRQ7: U28.10 (I1); also elsewhere on the board
!CS1_READ: U21.1 (G), U21.19 (G); also elsewhere on the board
!CS1_WRITE: U26.11 (CLK); also elsewhere on the board
!IVP: U16.1 (OC), U22.9 (Y6)
!RD: U22.5 (G2B); also elsewhere on the board
!RST: U26.1 (CLR); also elsewhere on the board
!VINT: U23.14 (GS); also elsewhere on the board
!VPB: U19.5 (I), U22.4 (G2A); also elsewhere on the board
A0: U22.1 (A); also elsewhere on the board
A1: U18.12 (I0), U22.2 (B); also elsewhere on the board
A2: U18.13 (I1), U22.3 (C); also elsewhere on the board
BD0: U14.3 (Y4), U16.19 (1Q), U21.18 (Y1), U26.18 (D8); also elsewhere on the board
BD1: U14.18 (Y1), U16.18 (2Q), U21.16 (Y2), U26.17 (D7); also elsewhere on the board
BD2: U14.5 (Y3), U16.17 (3Q), U21.14 (Y3), U26.14 (D6); also elsewhere on the board
BD3: U14.16 (Y2), U16.16 (4Q), U21.12 (Y4), U26.13 (D5); also elsewhere on the board
BD4: U14.7 (Y2), U16.15 (5Q), U21.9 (Y1), U26.8 (D4); also elsewhere on the board
BD5: U14.14 (Y3), U16.14 (6Q), U21.7 (Y2), U26.7 (D3); also elsewhere on the board
BD6: U14.9 (Y1), U16.13 (7Q), U21.5 (Y3), U26.4 (D2); also elsewhere on the board
BD7: U14.12 (Y4), U16.12 (8Q), U21.3 (Y4), U26.3 (D1); also elsewhere on the board
GND: U14.4 (A2), U14.6 (A3), U14.8 (A4), U14.10 (GND), U14.11 (A1), U14.13 (A2), U14.15 (A3), U14.17 (A4), U16.2 (1D), U16.3 (2D), U16.8 (7D), U16.9 (8D), U16.10 (GND), U17.7 (GND), U18.7 (GND), U19.7 (GND), U21.10 (GND), U22.8 (GND), U23.5 (EI), U23.8 (GND), U26.10 (GND), U27.7 (GND), U28.7 (GND); also elsewhere on the board
unnamed: U16.4 (3D), U23.9 (A0)
unnamed: U16.5 (4D), U23.7 (A1)
unnamed: U19.11 (I), U23.15 (EO)
unnamed: U17.13 (I1), U19.6 (O)
unnamed: U14.1 (G), U14.19 (G), U22.7 (Y7)
unnamed: U16.6 (5D), U23.6 (A2)
unnamed: U17.12 (I0), U18.11 (O)
unnamed: U23.10 (0), U28.8 (O)
unnamed: U16.7 (6D), U19.10 (O)
unnamed: U23.11 (1), U28.11 (O)
unnamed: U23.12 (2), U28.3 (O)
unnamed: U23.13 (3), U28.6 (O)
unnamed: U23.1 (4), U27.8 (O)
unnamed: U23.2 (5), U27.11 (O)
unnamed: U23.3 (6), U27.6 (O)
unnamed: U23.4 (7), U27.3 (O)
unnamed: U21.17 (A4), U26.2 (Q1), U28.9 (I0)
unnamed: U21.15 (A3), U26.5 (Q2), U28.12 (I0)
unnamed: U21.13 (A2), U26.6 (Q3), U28.1 (I0)
unnamed: U21.11 (A1), U26.9 (Q4), U28.4 (I0)
unnamed: U21.8 (A4), U26.12 (Q5), U27.9 (I0)
unnamed: U21.6 (A3), U26.15 (Q6), U27.12 (I0)
unnamed: U21.4 (A2), U26.16 (Q7), U27.4 (I0)
unnamed: U21.2 (A1), U26.19 (Q8), U27.1 (I0)
PH1: U16.11 (CLK); also elsewhere on the board
VCC: U14.2 (A1), U14.20 (VCC), U16.20 (VCC), U17.14 (VCC), U18.14 (VCC), U19.14 (VCC), U21.20 (VCC), U22.6 (G1), U22.16 (VCC), U23.16 (VCC), U26.20 (VCC), U27.14 (VCC), U28.14 (VCC); also elsewhere on the board

Notes on the sheet:
FFF8
FFF9
FFFA
FFFB
FFFC
FFFD
FFFE
FFFF
LSB
Interrupt Vector Generator
Takes individual card-specific interrupt requests and generates a prioritized interrupt vector. Individual IRQ lines can be masked with $X01
$X01
Interrupt Mask Write Register
Interrupt Mask Read Buffer
Interrupt Vector Register
MSB
Priority Encoder
Vector Chip Select
Memory Inhibit for Interrupt Vector
Project:
V2.4
Chris Weir
Sheet:

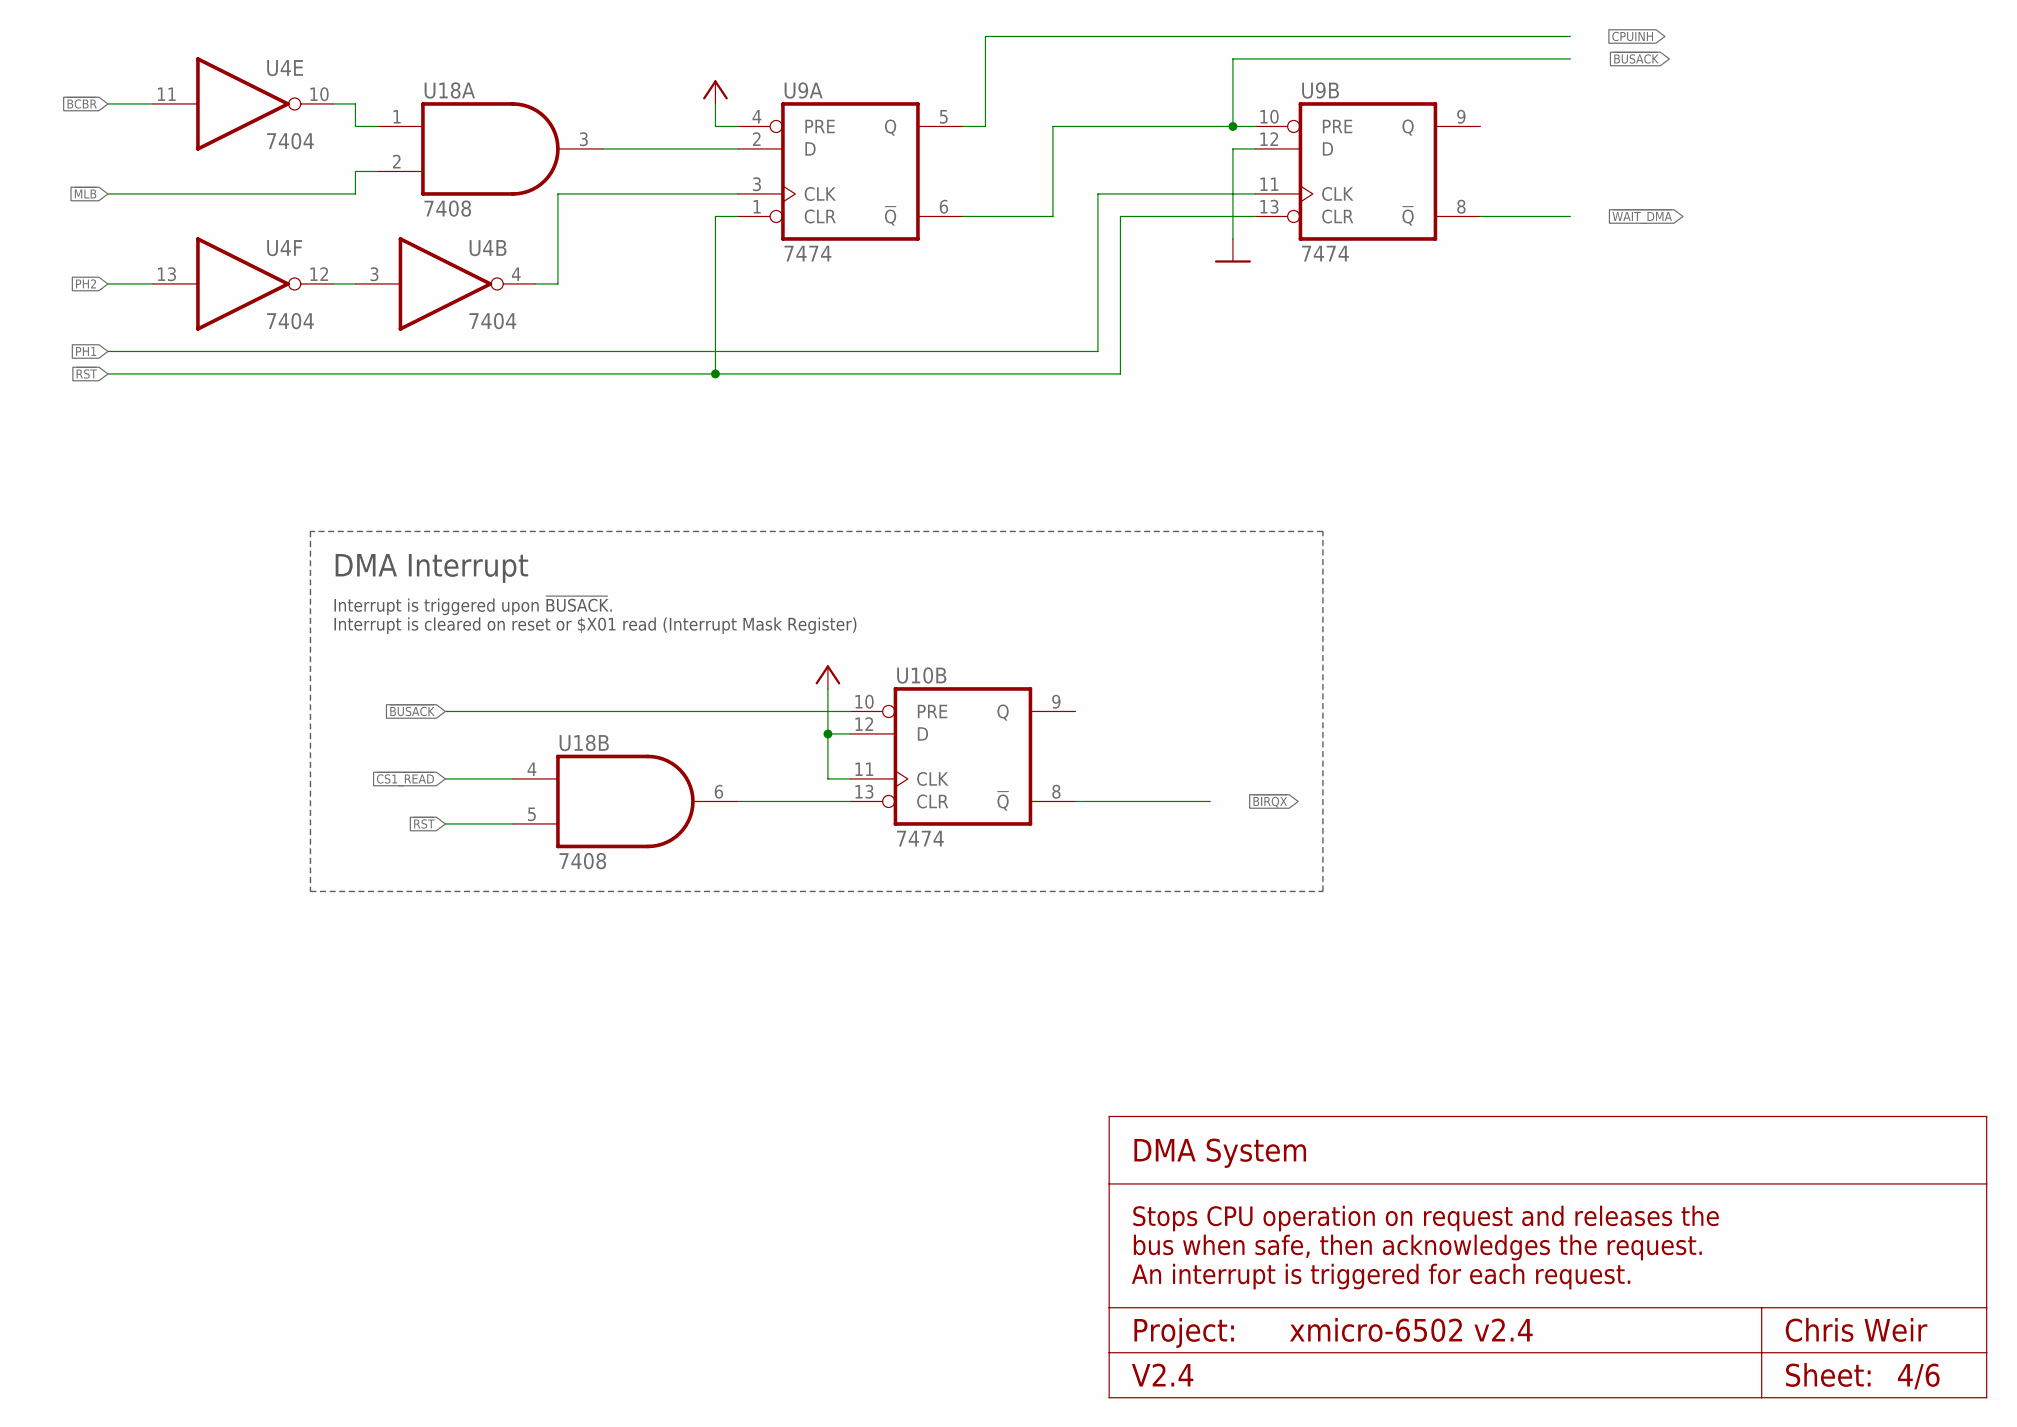
[picture p27: schematic XMICRO-6502 V2.4.sch, sheet 4, DMA System]

Parts:
U4: 7404; DIL14
U9, U10: 7474; DIL14
U18: 7408; DIL14

Connections:
!BCBR: U4.11 (I); also elsewhere on the board
!BIRQX: U10.8 (!Q); also elsewhere on the board
!BUSACK: U9.6 (!Q), U9.10 (PRE), U10.10 (PRE); also elsewhere on the board
!CS1_READ: U18.4 (I0); also elsewhere on the board
!MLB: U18.2 (I1); also elsewhere on the board
!RST: U9.1 (CLR), U9.13 (CLR), U18.5 (I1); also elsewhere on the board
!WAIT_DMA: U9.8 (!Q); also elsewhere on the board
CPUINH: U9.5 (Q); also elsewhere on the board
GND: U4.7 (GND), U9.7 (GND), U9.12 (D), U10.7 (GND), U18.7 (GND); also elsewhere on the board
unnamed: U9.2 (D), U18.3 (O)
unnamed: U10.13 (CLR), U18.6 (O)
unnamed: U4.10 (O), U18.1 (I0)
unnamed: U4.3 (I), U4.12 (O)
unnamed: U4.4 (O), U9.3 (CLK)
PH1: U9.11 (CLK); also elsewhere on the board
PH2: U4.13 (I); also elsewhere on the board
VCC: U4.14 (VCC), U9.4 (PRE), U9.14 (VCC), U10.11 (CLK), U10.12 (D), U10.14 (VCC), U18.14 (VCC); also elsewhere on the board

Notes on the sheet:
Interrupt is triggered upon !BUSACK!. Interrupt is cleared on reset or $X01 read (Interrupt Mask Register)
DMA System
Stops CPU operation on request and releases the bus when safe, then acknowledges the request. An interrupt is triggered for each request.
DMA Interrupt
Project:
V2.4
Chris Weir
Sheet:

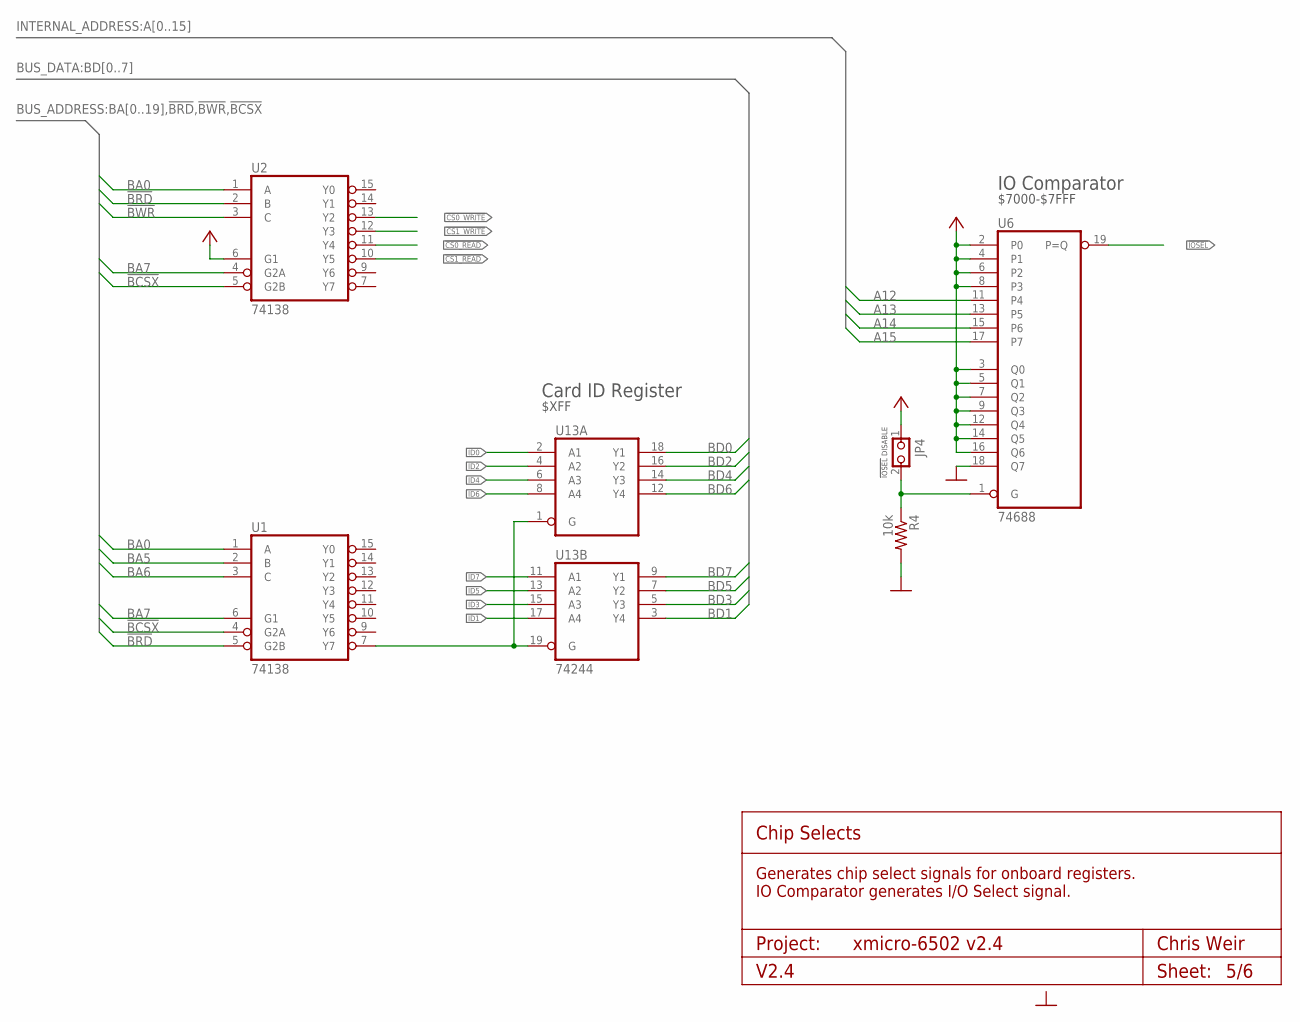
[picture p28: schematic XMICRO-6502 V2.4.sch, sheet 5, Chip Selects]

Parts:
JP4: PINHD-1X2THRU; 1X02
R4: 10k; 0207/10
U1, U2: 74138; DIL16
U6: 74688; DIL20
U13: 74244; DIL20

Connections:
!BCSX: U1.4 (G2A), U2.5 (G2B); also elsewhere on the board
!BRD: U1.5 (G2B), U2.2 (B); also elsewhere on the board
!BWR: U2.3 (C); also elsewhere on the board
!CS0_READ: U2.11 (Y4); also elsewhere on the board
!CS0_WRITE: U2.13 (Y2); also elsewhere on the board
!CS1_READ: U2.10 (Y5); also elsewhere on the board
!CS1_WRITE: U2.12 (Y3); also elsewhere on the board
!IOSEL: U6.19 (P=Q); also elsewhere on the board
A12: U6.11 (P4); also elsewhere on the board
A13: U6.13 (P5); also elsewhere on the board
A14: U6.15 (P6); also elsewhere on the board
A15: U6.17 (P7); also elsewhere on the board
BA0: U1.1 (A), U2.1 (A); also elsewhere on the board
BA5: U1.2 (B); also elsewhere on the board
BA6: U1.3 (C); also elsewhere on the board
BA7: U1.6 (G1), U2.4 (G2A); also elsewhere on the board
BD0: U13.18 (Y1); also elsewhere on the board
BD1: U13.3 (Y4); also elsewhere on the board
BD2: U13.16 (Y2); also elsewhere on the board
BD3: U13.5 (Y3); also elsewhere on the board
BD4: U13.14 (Y3); also elsewhere on the board
BD5: U13.7 (Y2); also elsewhere on the board
BD6: U13.12 (Y4); also elsewhere on the board
BD7: U13.9 (Y1); also elsewhere on the board
GND: R4.2, U1.8 (GND), U2.8 (GND), U6.10 (GND), U6.18 (Q7), U13.10 (GND); also elsewhere on the board
ID0: U13.2 (A1)
ID1: U13.17 (A4)
ID2: U13.4 (A2)
ID3: U13.15 (A3)
ID4: U13.6 (A3)
ID5: U13.13 (A2)
ID6: U13.8 (A4)
ID7: U13.11 (A1)
unnamed: JP4.2, R4.1, U6.1 (G)
unnamed: U1.7 (Y7), U13.1 (G), U13.19 (G)
VCC: JP4.1, U1.16 (VCC), U2.6 (G1), U2.16 (VCC), U6.2 (P0), U6.3 (Q0), U6.4 (P1), U6.5 (Q1), U6.6 (P2), U6.7 (Q2), U6.8 (P3), U6.9 (Q3), U6.12 (Q4), U6.14 (Q5), U6.16 (Q6), U6.20 (VCC), U13.20 (VCC); also elsewhere on the board

Notes on the sheet:
Chip Selects
Generates chip select signals for onboard registers. IO Comparator generates I/O Select signal.
$XFF
Card ID Register
Project:
V2.4
Chris Weir
Sheet:
$7000-$7FFF
IO Comparator
!IOSEL! DISABLE
