X-Microsystems/xmicro-6502/Hardware/CAD/XMICRO-6502 V2.4.brd

## EAGLE design Hardware/CAD/XMICRO-6502 V2.4.brd (continued)

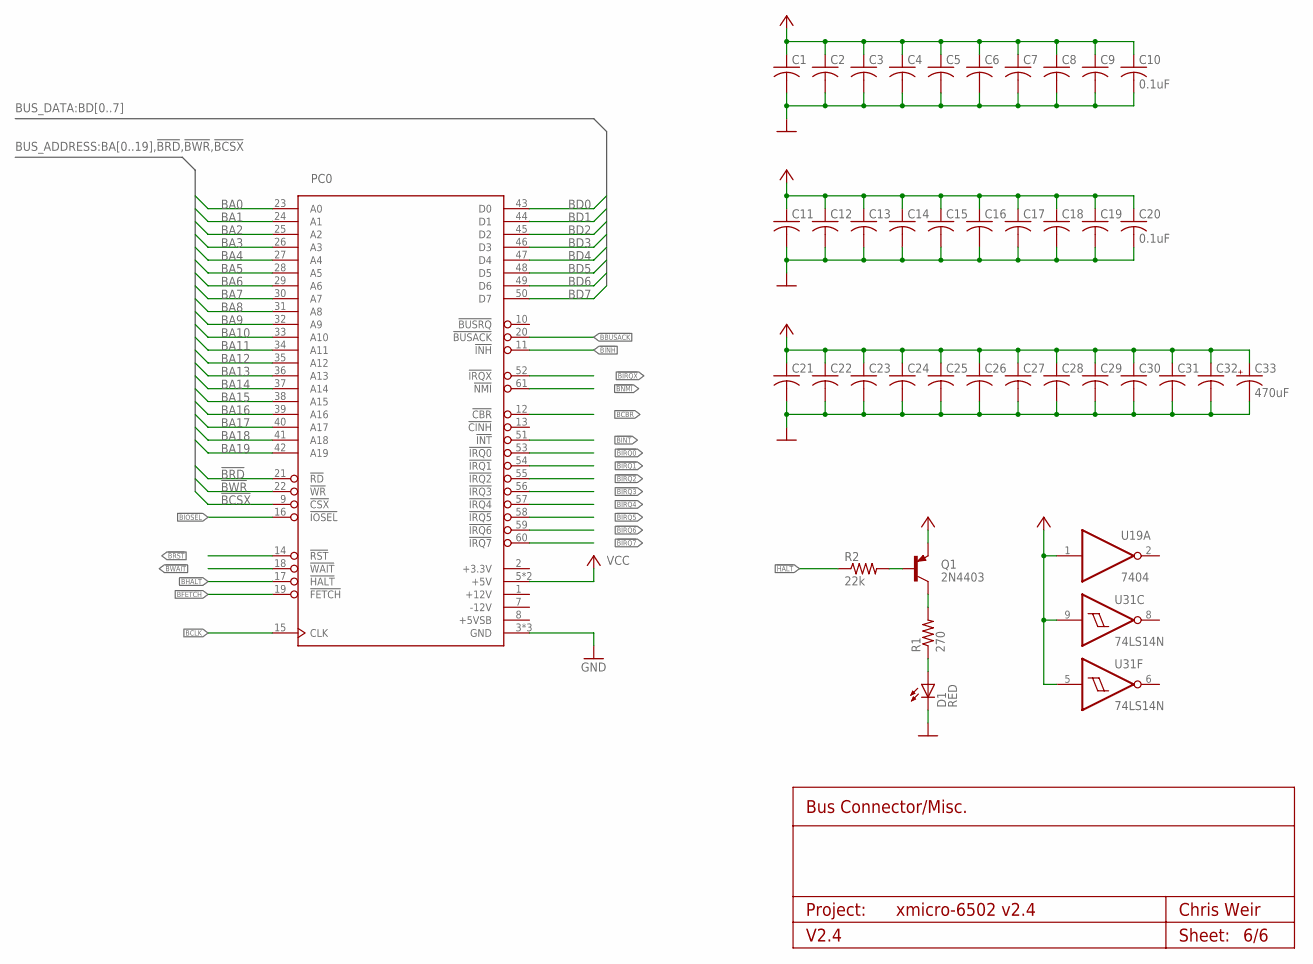
[picture p29: schematic XMICRO-6502 V2.4.sch, sheet 6, Bus Connector/Misc.]

Parts:
C1, C2, C3, C4, C5, C6, C7, C8, C9, C10, C11, C12, C13, C14, C15, C16, C17, C18, C19, C20, C21, C22, C23, C24, C25, C26, C27, C28, C29, C30, C31, C32: 0.1uF; C025-024X044
C33: 470uF; C-10-5
D1: RED; LED5MM
PC0: XMICRO-BUS-EDGE62M; EDGE62M
Q1: 2N4403; TO92
R1: 270; 0207/10
R2: 22k; 0207/10
U19: 7404; DIL14
U31: 74LS14N; DIL14

Connections:
!BBUSACK: PC0.20 (!BUSACK); also elsewhere on the board
!BCBR: PC0.12 (!CBR); also elsewhere on the board
!BCSX: PC0.9 (!CSX); also elsewhere on the board
!BFETCH: PC0.19 (!FETCH); also elsewhere on the board
!BHALT: PC0.17 (!HALT); also elsewhere on the board
!BINH: PC0.11 (!INH); also elsewhere on the board
!BINT: PC0.51 (!INT); also elsewhere on the board
!BIOSEL: PC0.16 (!IOSEL); also elsewhere on the board
!BIRQ0: PC0.53 (!IRQ0); also elsewhere on the board
!BIRQ1: PC0.54 (!IRQ1); also elsewhere on the board
!BIRQ2: PC0.55 (!IRQ2); also elsewhere on the board
!BIRQ3: PC0.56 (!IRQ3); also elsewhere on the board
!BIRQ4: PC0.57 (!IRQ4); also elsewhere on the board
!BIRQ5: PC0.58 (!IRQ5); also elsewhere on the board
!BIRQ6: PC0.59 (!IRQ6); also elsewhere on the board
!BIRQ7: PC0.60 (!IRQ7); also elsewhere on the board
!BIRQX: PC0.52 (!IRQX); also elsewhere on the board
!BNMI: PC0.61 (!NMI); also elsewhere on the board
!BRD: PC0.21 (!RD); also elsewhere on the board
!BRST: PC0.14 (!RST); also elsewhere on the board
!BWAIT: PC0.18 (!WAIT); also elsewhere on the board
!BWR: PC0.22 (!WR); also elsewhere on the board
!HALT: R2.1; also elsewhere on the board
BA0: PC0.23 (A0); also elsewhere on the board
BA1: PC0.24 (A1); also elsewhere on the board
BA2: PC0.25 (A2); also elsewhere on the board
BA3: PC0.26 (A3); also elsewhere on the board
BA4: PC0.27 (A4); also elsewhere on the board
BA5: PC0.28 (A5); also elsewhere on the board
BA6: PC0.29 (A6); also elsewhere on the board
BA7: PC0.30 (A7); also elsewhere on the board
BA8: PC0.31 (A8); also elsewhere on the board
BA9: PC0.32 (A9); also elsewhere on the board
BA10: PC0.33 (A10); also elsewhere on the board
BA11: PC0.34 (A11); also elsewhere on the board
BA12: PC0.35 (A12); also elsewhere on the board
BA13: PC0.36 (A13); also elsewhere on the board
BA14: PC0.37 (A14); also elsewhere on the board
BA15: PC0.38 (A15); also elsewhere on the board
BA16: PC0.39 (A16); also elsewhere on the board
BA17: PC0.40 (A17); also elsewhere on the board
BA18: PC0.41 (A18); also elsewhere on the board
BA19: PC0.42 (A19); also elsewhere on the board
BCLK: PC0.15 (CLK); also elsewhere on the board
BD0: PC0.43 (D0); also elsewhere on the board
BD1: PC0.44 (D1); also elsewhere on the board
BD2: PC0.45 (D2); also elsewhere on the board
BD3: PC0.46 (D3); also elsewhere on the board
BD4: PC0.47 (D4); also elsewhere on the board
BD5: PC0.48 (D5); also elsewhere on the board
BD6: PC0.49 (D6); also elsewhere on the board
BD7: PC0.50 (D7); also elsewhere on the board
GND: C1.2, C2.2, C3.2, C4.2, C5.2, C6.2, C7.2, C8.2, C9.2, C10.2, C11.2, C12.2, C13.2, C14.2, C15.2, C16.2, C17.2, C18.2, C19.2, C20.2, C21.2, C22.2, C23.2, C24.2, C25.2, C26.2, C27.2, C28.2, C29.2, C30.2, C31.2, C32.2, C33.-, D1.K (C), PC0.3 (GND), PC0.4 (GND), PC0.62 (GND), U19.7 (GND), U31.7 (GND); also elsewhere on the board
unnamed: Q1.2 (B), R2.2
unnamed: Q1.3 (C), R1.2
unnamed: D1.A, R1.1
VCC: C1.1, C2.1, C3.1, C4.1, C5.1, C6.1, C7.1, C8.1, C9.1, C10.1, C11.1, C12.1, C13.1, C14.1, C15.1, C16.1, C17.1, C18.1, C19.1, C20.1, C21.1, C22.1, C23.1, C24.1, C25.1, C26.1, C27.1, C28.1, C29.1, C30.1, C31.1, C32.1, C33.+, PC0.5 (+5V), PC0.6 (+5V), Q1.1 (E), U19.1 (I), U19.14 (VCC), U31.5 (I), U31.9 (I), U31.14 (VCC); also elsewhere on the board

Notes on the sheet:
Bus Connector/Misc.
Project:
V2.4
Chris Weir
Sheet:

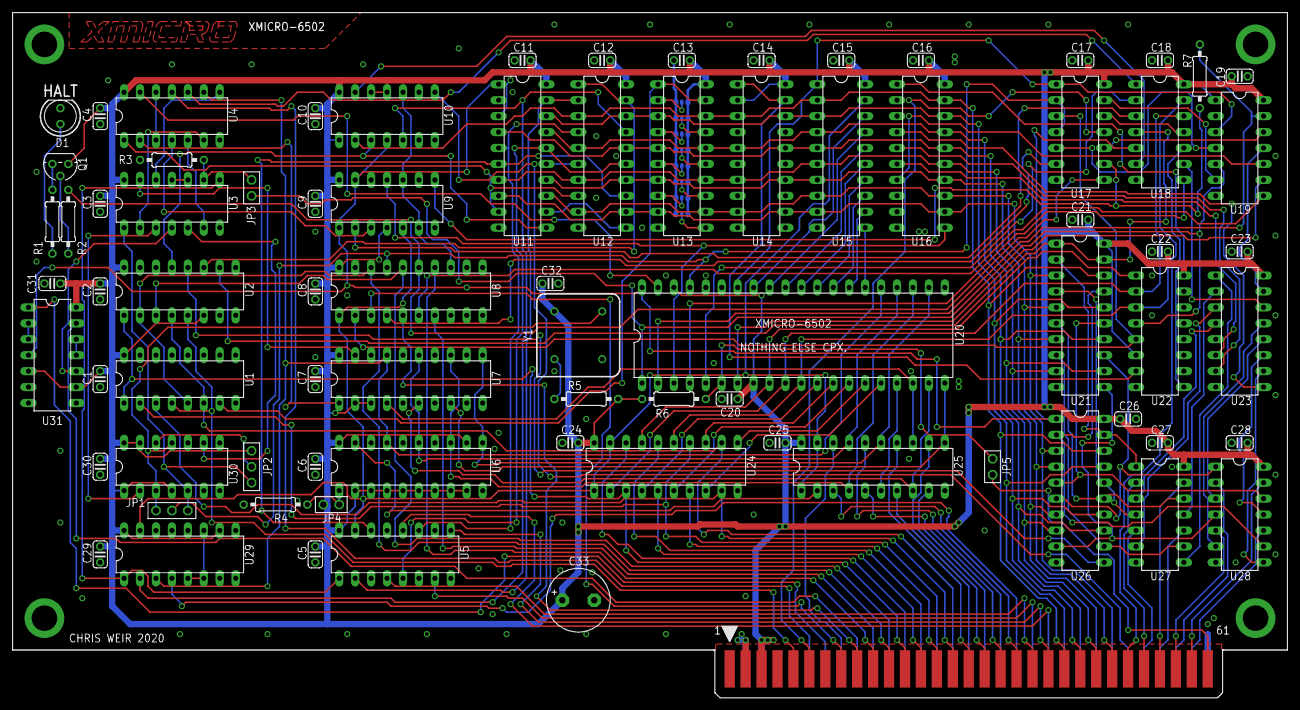
[picture p30: board XMICRO-6502 V2.4.brd from above]

Board: 2 copper layers, 203.2 x 109.2 mm, 80 parts (0 on the bottom side), 163 nets.
