X-Microsystems/xmicro-6502/(commit log)

2019-03-24 Rearranged hardware directory
    [XMICRO-6502 V2.1.brd, XMICRO-6502 V2.1.sch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]
2019-03-24 Removed CAD/CAM from documentation directory
    [XMICRO-6502 BOM.csv, XMICRO-6502.brd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]
2019-03-24 Added documentation for hardware V2
    [XMICRO-6502 V2.1 BOM.csv]
2019-05-28 Updated schematic xrefs to indicate signal direction.
    [XMICRO-6502 V2.1.sch]
2019-12-09 Updated to V2.3. Fixed wait states.
    [XMICRO-6502 V2.1 BOM.csv, XMICRO-6502 V2.1.brd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]
2020-03-30 Updated to V2.4 - made it necessary to manually clear DMA interrupts
    [XMICRO-6502 V2.4 BOM.csv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]
2025-08-05 Updated Readme and photos
    [XMICRO-6502 V2.4 BOM.csv]
